buryalcin/EE464_Hardware_POWERLOVERS/README.md

# EE464_Hardware_POWERLOVERS
EE464 Hardware Project Repo by Burak Yalçın &amp; Emre Deniz Şenel
