buryalcin/EE464_Hardware_POWERLOVERS/Latex/Appendix.tex

\section{Appendix : Bill of Material Files}

\includepdf[pages=-]{BOM.pdf}
\includepdf[pages=-]{BOM_1000.pdf}
