buryalcin/EE464_Hardware_POWERLOVERS/Latex/References.tex

\begin{thebibliography}{9}
\bibitem{1} 
Transformer Design with Magnetics Ferrite Cores. [Online]. Available: https://www.mag-inc.com/Design/Design-Guides/Transformer-Design-with-Magnetics-Ferrite-Cores.

\bibitem{2}
"AN-776 20 Watt Simple Switcher Forward Converter", 2020. [Online]. Available: https://www.ti.com/lit/an/snva027a/snva027a.pdf?ts=1592752724490

\bibitem{3}
 N. Mohan, T. M. Undeland, and W. P. Robbins, Power Electronics: Converters, Applications, and Design. Hoboken, NJ: John Wiley \& Sons, 2003.

\bibitem{4}
"Compensator Design Procedure for Buck Converter with Voltage-Mode Error-Amplifier", Infineon.com, 2020. [Online]. Available: https://www.infineon.com/dgdl/an-1162.pdf?fileId=5546d462533600a40153559a8e17111a.

\bibitem{5}
Designing Switching Voltage Regulators With the TL494", 2020. [Online]. Available: https://www.ti.com/lit/an/slva001e/slva001e.pdf?ts=1592314978873

\end{thebibliography}
