buryalcin/EE464_Hardware_POWERLOVERS/Latex/titlepage.tex

\begin{titlepage}
\newcommand{\HRule}{\rule{\linewidth}{0.5mm}}
\setlength{\topmargin}{0 in}
\begin{center}
\begin{figure}[!h]
\centering
\includegraphics [width=0.3\textwidth]{eelogo.png}
\end{figure}

\vspace{10mm}
\Huge{MIDDLE EAST TECHNICAL UNIVERSITY}\\
\vspace{5mm}
{\LARGE ELECTRICAL \& ELECTRONICS ENGINEERING}\\

\HRule\\[0.4cm]
\textsc{\Large{EE464 - STATIC POWER CONVERSION II}}\\
\textsc{\Large{Hardware Project - Forward Converter \#1\\}}
\textsc{\Large{PowerLovers\\}}
\textsc{\Large{Final Report\\}}
\HRule\\[0.4cm]

\vspace{3mm}

\end{center}
\begin{minipage}{1\textwidth}
		\begin{flushleft}
			\large
			
			Emre Deniz  \textsc{Şenel - 2167237}\\
			Burak \textsc{Yalçın      - 2167534}\\

		\end{flushleft}
	\end{minipage}

\vspace{10mm}
\begin{center}
\large{24.06.2020}
\end{center}
\end{titlepage}
