buryalcin/EE464_Hardware_POWERLOVERS/Hardware_Final_Report.pdf

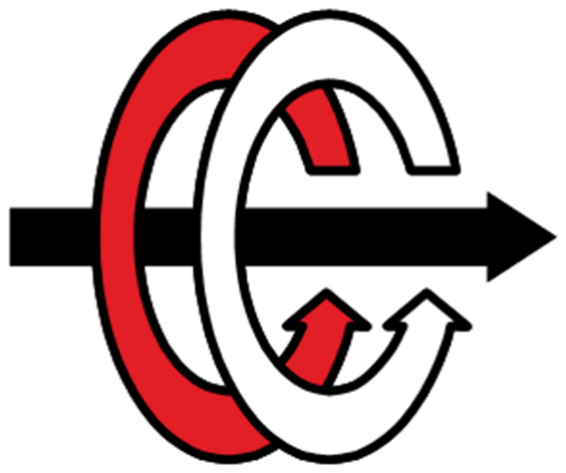
[picture p3: figure]

# MIDDLE EAST TECHNICAL UNIVERSITY

## ELECTRICAL & ELECTRONICS ENGINEERING

EE464 - STATIC POWER CONVERSION II

Hardware Project - Forward Converter #1

PowerLovers

Final Report

Emre Deniz Şenel - 2167237

Burak Yalçın - 2167534

24.06.2020

## Contents

1 Introduction | 3
2 Problem Definition, Objectives and Bonus Points | 3
3 Forward Converter | 4
4 Design of the Forward Converter | 5
5 Ideal Simulations | 12
6 Non-idealities of Forward Converter | 15
7 Transfer Function and Compensator Design | 19
8 Efficiency and Thermal Analysis | 30
9 PCB Design | 34

1

10 Conclusion | 45
11 Appendix : Bill of Material Files | 46

2

## 1 Introduction

Static Power Conversion II, a self-defined course, offers numerous isolated and non-isolated converters, inverters and their applications. In Spring’20, the theoretical background that have been acquired is to be turned into a hardware implementation of the combined knowledge all together. However, due to the pandemic, it is not possible to introduce a product but present a detailed design with software supports and PCB design. In this report, forward converter design of group Powerlovers will be introduced. Background information with objectives will take place. Then, all the steps of the projects, tests, design procedures and simulation results will be exhibited. We strongly believe, this project helped us understand the concepts we learnt in the lectures, and we had a chance to see beyond the horizons.

## 2 Problem Definition, Objectives and Bonus Points

In the project, we are to do a forward converter design with specific properties.

Table 1: Parameters of the project

Minimum Input Voltage (V) | 24
Maximum Input Voltage (V) | 48
Output Voltage (V) | 15
Output Power (W) | 48
Output Volt. Peak-to-Peak Ripple (%) | 2
Line Regulation (%) | 2
Load Regulation (%) | 2

Some of the points and objectives can be itemized as:

- Closed loop is a must and we are not allowed to use digital controllers
- PCB design of the converter will be presented.
- Bill of material will be presented
- Closed loop compansator design with bode-plot is a bonus
- We are to do thermal design and efficiency analysis of the project

We have mentioned couple of specifications of the project. Our goal was to accomplish the main specifications and add as much as bonus we can.

In the next section we are introduce a forward converter.

3

## 3 Forward Converter

### 3.1 General Structure

Forward converter is basically derived from the buck converter. We are going to observe the relationship in the derivation phase. Forward converter is isolated as we know, and it uses transformer as its regular use. Transformer transfers the power to the secondary side and it does not store energy in between. In forward converter, it is important to take the magnetizing current into account.

In Figure 3.1.1, the forward converter topology can be observed. This is the most simple model.

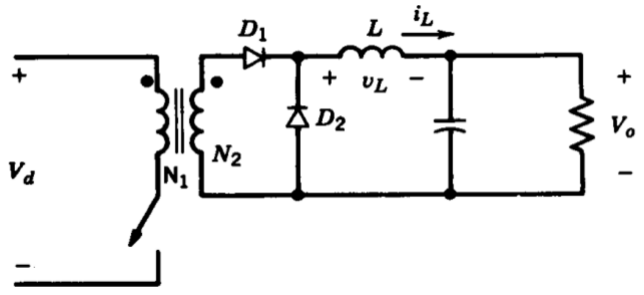
[picture p4: figure]

Figure 3.1.1: Forward Converter Topology

Assume the transformer is ideal for now to obtain the transfer function of the topology.
During the ON state of the switch, D1 is conducting and D2 is reverse biased. Therefore, the inductor voltage can be written down as

VL =

N2
N1

Vd − Vo

Let us examine now the OFF state of the switch. D1 is now reverse biased on D2 forms a free-wheeling path for the inductor. Load is fed by the stored energy in the inductor and the capacitor. Inductor voltage is easy to obtain and is as follows.

VL = −Vo

Discussion so far end with applying the voltage-seconds rule for the inductor and this yields the transfer function of the forward converter topology as

Vo
Vd

=

N2
N1
D | (1)

4

However, a question might arise rightfully at this point: how does this topology deal with the magnetizing current? During the OFF state, Lm has no path to discharge and it seems to be charged again and again during ON state. This situation ends up saturating the core and threatens the proper operation of the converter.
A variety of solutions for this problem are available. A snubber circuitry connected in parallel to the primary winding, a two switch topology are among them. A more practical and wide-spread application ,however, is adding a third reset winding. The resultant topology can be seen in Figure 3.1.2.

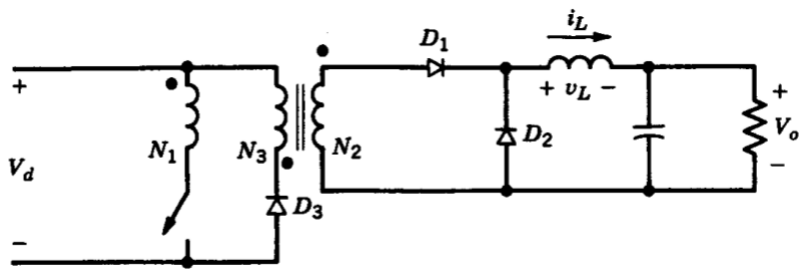
[picture p5: figure]

Figure 3.1.2: Practical Forward Converter Topology

In this topology, the third winding namely N3 is in use in order to reset the winding so that the core does not saturate. As its nature opposes, the forward converter has limitations itself. One and the most important thing is that Dmax namely maximum duty cycle is limited to the following equation

Dmax =

1
1 + N3/N1

(2)

In most of the cases, N1 = N3 is taken to simplify the structure and the organization. We followed the same approach in our solutions.

## 4 Design of the Forward Converter

### 4.1 System Level Design

The most important element in isolated power supplies is the transformer. Without knowing the transformer properties, it is not possible to move on with the simulations. Hence, the design process is now orderly. Output inductor and capacitor can also be chosen by theoretical knowledge.

5

Although it is possible to have a "pre-simulation" idea on the voltage stresses or current carrying capabilities for the semiconductor devices in the topology, it is safer to choose them in the guidance of the simulation results. Some of the non-idealities will also be involved in the simulations as well, allowing us to make more accurate assumptions about component selection.

In this part, we need to look at general specifications of the forward converter. Our customer, from Habelsan, asked us to satisfy these specifications:

- Input voltage rate: 24V − 48V
- Output voltage: 15V
- Output power: 48W
- Output voltage ripple: 2%, maximum
- Line and Load regulations: 2%, maximum

Firstly, we need to look at input-output voltage relationship of the forward converter. Ratio between the two is derived in the previous parts as:

Vo
Vd

=

N2
N1
D | (3)

Output current’s average value is 48W
15V = 3.2A. As mentioned before, demagnetization of the core in the forward converter is important. Among different techniques,it is decided to use a reset winding. Turn number of the reset winding is chosen to be equal to that of the primary winding, conventionally and we will stick to that convention as well. This situation puts a restriction on the duty cycle to ensure proper demagnetization of the core.Duty cycle for the operation should be D < 0.5.

Turns Ratio & Duty Cycle

In the project, required voltage transfer ratios are 48V to 15V, and 24V to 15V. It is important to take into account that the limit of duty cycle is Dmax = 0.5, and it is very crucial to reset all the core.

Using the input output equation and duty cycle restrictions, we choose the turn ratio between first and secondary winding as:

N2
N1

= 2

Using these ratio, it is now easy to find required duty ratios. For 48V input,

D =

48
15

= 2 =⇒ Dmin = 0.156

6

and For 24V input,

D =

24
15

= 2 =⇒ Dmax = 0.3125

As can be seen, the duty cycle ratios obey the restrictions and they also allow a margin to compensate for the non-idealities.

Frequency

As switching frequency of the MOSFET, it is important to note that higher frequencies increases the switching losses. Also, at high frequencies, skin depth of the cable decreases dramatically. Moreover, it is also needed to be pointed that at higher frequencies hysteresis losses increase in the core. Therefore, we decided to keep our frequency less than 30kHz, f < 30kHz

Secondly, as frequency decreases, the amount of ripple at the output increases due to longer switching periods. Furthermore, it is important to keep the frequency at inaudible range so that the converter is not noisy. We decided that frequency should be higher than 20kHz, f > 20kHz.

Combining these two
20kHz < f < 30kHz

In the simulations, we decided as the best frequency would be 25kHz. Therefore, for our forward converter the frequency is f = 25kHz

### 4.2 Transformer Design

In the forward converter topology, it is important to realize the fact that transformer is introduced in order to transfer the power from primary to secondary. For this reason, we do not need any air gap in our transformer design. Moreover, a transformer with high inductance will allow us to operate in low magnetizing current levels due to high impedance of the inductor. When we combine these, we can start our calculations.

The first approach is to calculate W aAc, it shows the power handling capacity of our transformer. Its formula is as follows [1]:

WaAc =

PoDcma

KtBmaxf

(4)

Here Po = 48W, power out in watts, Dcma = 500 cir/mils.amp, is current density, Kt = 0.0005, topology constant given for forward converter. Bmax = 2500G, maximum flux density in gauss and f = 25kHz is the frequency.

When we calculate the result

WaAc = 0.768 cm⁴

7

Now, using the magnetics’ available cores offered for power handling capacities, we are going to choose a proper core. We chose an R material E shaped core, it is high in inductance and low in loss. It is very proper for this application.

The core link: Core (https://www.mag-inc.com/Media/Magnetics/Datasheets/0R43515EC.pdf)

Now it is important to choose turn number for primary side. The secondary and third windings depend on the primary side. We are going to apply following approach:

Np =

Vp10⁸
4BAcf

(5)

We choose following parameters for this application: Vp = 48V , B = 0.25T, Ac = 0.87cm² it given
in the datasheet of the core and f = 25kHz. The result is:

Np = 22 turn

Naturally, we have N1 = 22, N2 = 44, N3 = 22 due to our selection.

The turns number for windings are determined as

- Primary winding, n1 = 22 turns
- Reset winding, n3 = 22 turns
- Secondary winding, n2 = 44 turns

Now, it is very important to take magnetizing inductance into account. In the datasheet we can easily see that the AL value is given as AL = 2667nH/T²
. As we decided our turn number is 22, we can easily calculate the magnetizing inductance as:

Lm = 22²

∗ 2667 ∗ 10⁻⁹ = 1.3mH

This is a great value becuase a low magnetizing inductance will increase the magnetizing current at the primary side, as a result we would need a higher current capability. However, 1.3mH is a legitimate value. If we calculate the magnetizing current at operating frequency:

Im =

V
Z

= 0.235A

### 4.3 Cable Selection

In practical cases maximum fill factor achievable is stated at 50%. We need to take these two parameters into account.

8

Moreover, it is important to notice that, the input current at the maximum operation is Iin = 2A and Im = 0.235A, as overall we need minimum of I1 = 2.3A at the primary side. At the secondary side we are going to have a maximum of Io = 3.2A, we have to take these into account.

Using a simple approach 1mm² of cable can carry 4A, and considering skin depth. We have chosen to use AWG22 cable. It’s area is 0.327mm² and it can carry a current up to 1.3A. Also, it’s maximum skin depth is applicable up to 42kHz, that is to say since our operating frequency is 25kHz, this cable is proper to use. Considering margins, we are going to choose needed parallel cable amount.

In the output we need 2 parallel cables, and at the output we need 3 parallel cables.

Now, it is important to have a look at the fill factor. It is very crucial to have a fill factor around 50% so that our transformer is realizable.

If we calculate the cable areas:

Acable = 0.326 ∗ 22 + 0.326 ∗ 22 + 0.326 ∗ 44 = 71.9mm²

If we check our core’s window area, we can see that it is:

Awindow = 9.8 ∗ 8 ∗ 2 = 156.8mm²

So the fill factor of our transformer is:

k =

61.1
156.8

= 46%

This fill factor is applicable and not an overdesign. Therefore, the cable selections are proper. We have a legitimate fill factor, we have 100% skin depth, and we have margins so that there is no burnout. In the next step we are going to cover the capacitor and inductor.

### 4.4 Inductor and Capacitor Design

To design the inductor, we are focus on the maximum ripple current allowed. In the specifications, it is not determined, so we are going to have 20% maximum ripple current so that our output current would be out of harmonics and the filtering capacitor would be smaller.

At the ON period, the inductor is charging, and using the voltage among the terminals we can find the ripple current value.

∆I =

1
L

Z DTs

0

VLdt < 3.2A
5

∆I =

1
L

Z DTs

0

(Vs

N2
N1

− Vo)dt < 0.64A

9

0.62mH < L

Also, it is very important to take rated current into account. The minimum rated current that inductor can carry must be minimum of 3.2A + 0.65A ≈ 3.8A

Using digikey website, we chose a proper inductor. It is important to have a small inductor in order to decrease the size and the weight.

Inductor Link: Inductor (https://www.digikey.com/product-detail/en/bourns-inc/2300LL-681-H-RC/2300LL-681-H-RC-ND/725890)

Capacitor design is depending on the inductor design. As we know, we have to limit the ripple value of the output voltage. Also, the current that is flowing through the output is equal to the inductor current. We need to follow the following approach.

∆V =

∆Q
C

(6)

∆Q = ∆IL ∗

Ts
8

(7)

Here, we are using buck converter capacitor design approach. They are same in the application:

∆V = 0.3V >

DT²
s

(Vs

N2
N1

− Vo)

8LC

C > 28µF

Also, apparently the rated voltage of the capacitor should be higher than the rated voltage of the output, for that reason Cv,rated > 15V

Capacitor Link: Capacitor (https://product.tdk.com/info/en/documents/chara_sheet/C3216JB1E336M160AC.pdf)

ESR value of the capacitor is: 3 mΩ

### 4.5 Switch and Diode Design

In these voltage levels and frequency levels it is proper to use MOSFET due to their fast recovery. It is also easy to implement a MOSFET into a converter. While designing the MOSFET, it is very important not to exceed its rated voltage and current values.

In the simulations with idealities, we came up with the values that:

- Switch stress has its maximum values for input of 48V naturally. We can say that our switch must be endurable minimum of 100V rated reverse voltage and 10A forward voltage.

10

- Switch must be proper to operate at 25kHz range, reverse recovery times should be appropriate.

We have chosen an N-Channel MOSFET with ratings 10 A, 150 V. The MOSFET Link: MOSFET (https://www.digikey.com/product-detail/en/on-semiconductor/FDMS86255/FDMS86255TR-ND/4555505)

Silicon diodes are proper because they are cheap in cost and they have proper operation for this implementation range.

In the simulations with idealities, we came up with the values that:

- Diode’ stress have their maximum values for input of 48V naturally. We can say that switches must be endurable minimum of 100V rated reverse voltage and 4A forward voltage.
- Diode must be proper to operate at 25kHz range, reverse recovery times should be appropriate.

A Schottky diode with ratings 5A and 100 V is chosen for our application.

The Diode Link: Diode (https://www.digikey.com/product-detail/en/vishay-semiconductor-diodes-division/SS5P10-M3-86A/SS5P10-M3-86AGICT-ND/2048223)

11

## 5 Ideal Simulations

### 5.1 Simulation Results

Below in the Figure 5.1.1, the simulation model schematic can be seen.

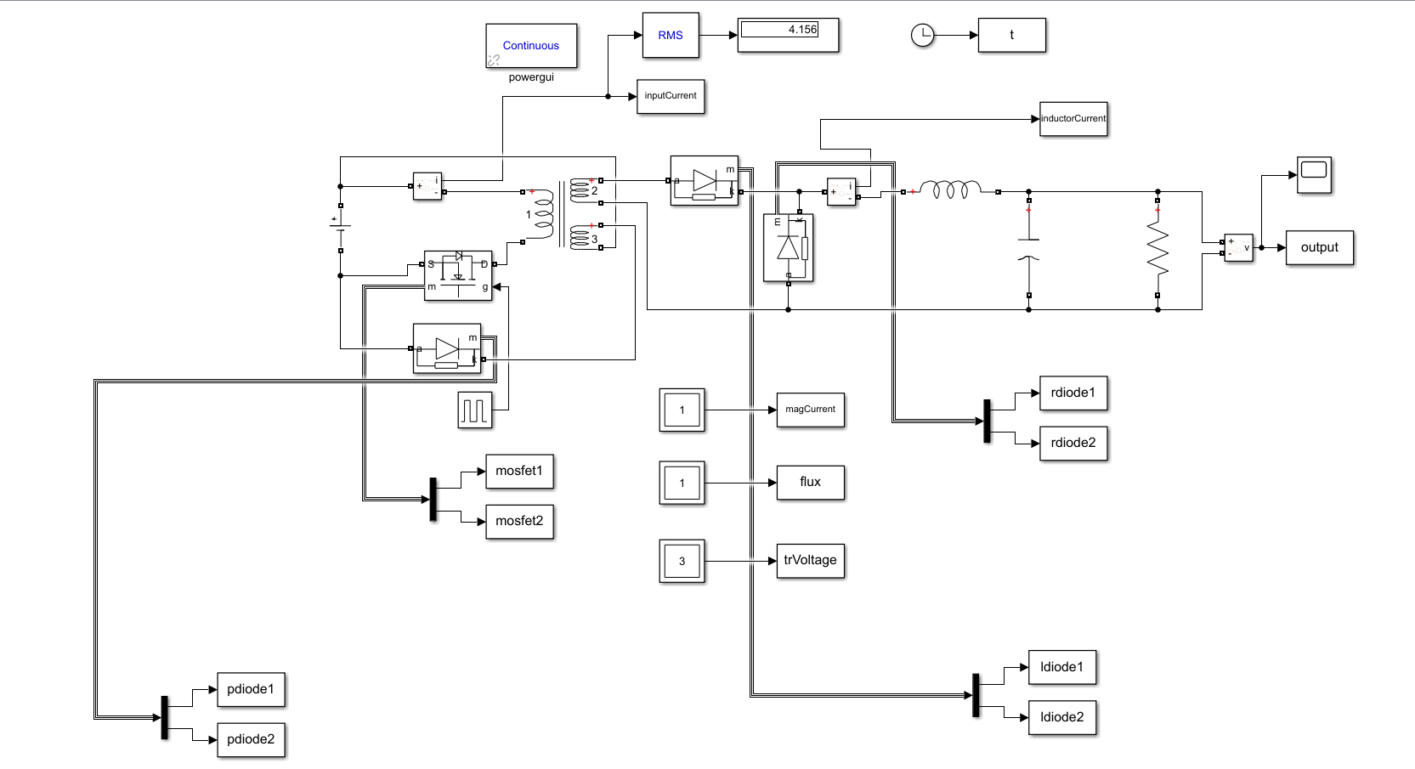
[picture p6: figure]

Figure 5.1.1: Simulation model

First, we simulated the ideal models in order to see the overall system operation. It is open-loop operation simulation and we would like to validate the duty cycles, operation principle and validity of our selections.

12

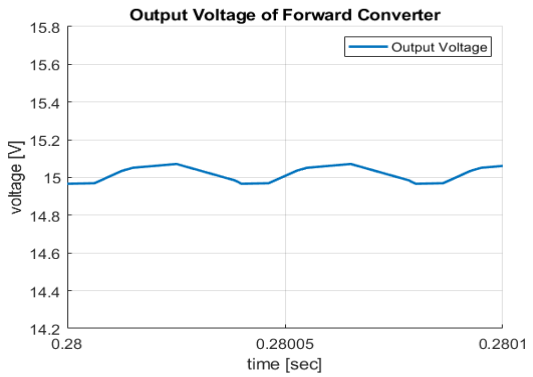
[picture p7: figure]

Figure 5.1.2: Output waveform of the forward converter under 48V operation

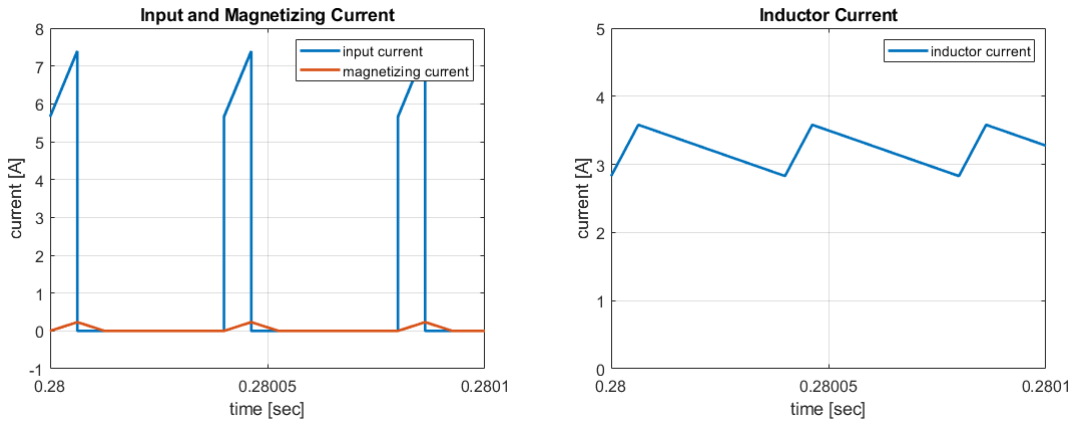
[picture p8: figure]

(a) Input and Magnetizing Current | (b) Inductor Current

Figure 5.1.3: Forward converter input and inductor current under 48V input operation

13

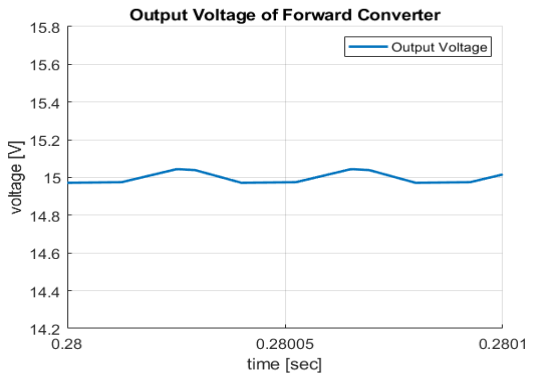
[picture p9: figure]

Figure 5.1.4: Output waveform of the forward converter under 24V operation

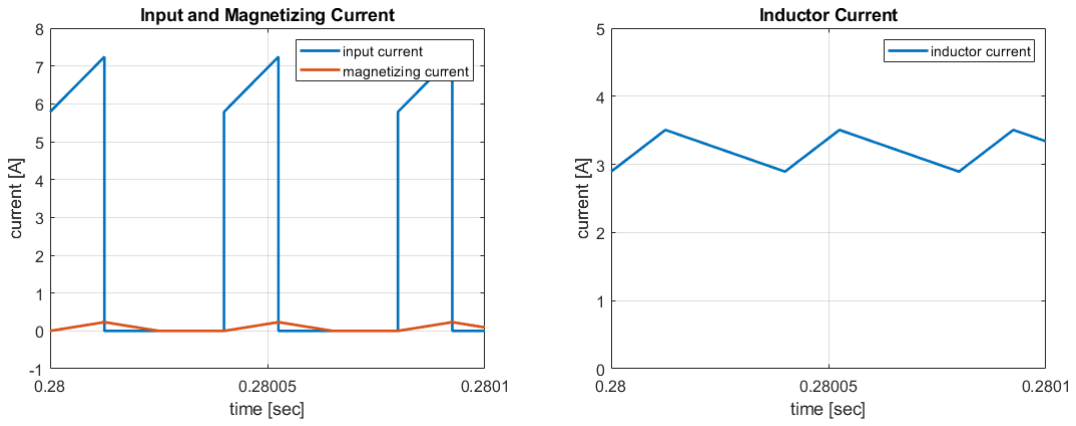
[picture p10: figure]

(a) Input and Magnetizing Current | (b) Inductor Current

Figure 5.1.5: Forward converter input and inductor current under 24V input operation

As we can see from the Fig. 5.1.4 and 5.1.2 the output ripple is below 2%. The operation is stable and the duty cycles are as expected. However, when non-idealities are presented the duty cycle values will be re-calculated in order to compansate the voltage drops of losses and diodes etc.

14

Also, from the Fig. 7.3.2 and 5.1.3, we can observe the magnetizing current is as expected around 0.3A and the inductor ripple is around 0.6A for both operations. These results show that our calculations are valid. Now we are going to add non-idealities of the circuit.

## 6 Non-idealities of Forward Converter

### 6.1 Adding the Non-idealities and Their Solutions

Firstly, we added the loss components of the MOSFET and the diodes. As we can see from the datasheet, MOSFET has Rds,ON = 12.4mΩ, this value is added to the MOSFET. Then, the forward voltage values of the diodes are added to the software Vf = 0.7V in our operation topology. After adding these, Rd,ON = 1mΩ added for the diodes representing the losses on the selected diodes.

Series resistance of the inductor is given as maximum of Rmax = 0.113Ω for convenience we took this value as 0.6Ω to obtain an average operation range. Also, using the datasheet of the capacitor, we found out that the ESR value of the capacitor is around 3mΩ. This is a low value, because the capacitor is a seramic capacitor and it has very low ESR operation.

Next step was to add the leakage inductances of the transformer, we have taken the leakage inductance as 1% of the magnetizing inductance and introduced the leakage inductance as 13µH to the primary side of the transformer. Also, copper resistances added to the non-ideal system. At primary R1 = 0.33Ω at secondary R2 = 0.44Ω

Then it is very crucial to notice that the stored energy in the leakage inductance needs a way to decharge itself. For this very reason it is very important to design a snubber circuit around the MOSFET in order to block burnouts and have a smooth operation. We have decided to move on with a RC Snubber.

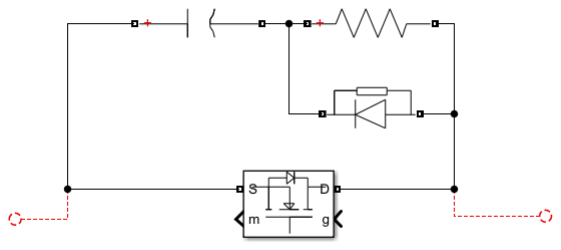
[picture p11: figure]

Figure 6.1.1: Snubber Layout

When designing the RC snubber we can use an
Application Note [2], in the application note, there is a snubber designed. We changed the R and C variables in order to adjust the solution into our problem. We have twice of voltage at the input and the current is twice. So, we used four times of R and two times of C. The values and the layout is in Figure 7.3.1:

R = 1250Ω, C = 0.5µF

### 6.2 Simulation of Non-ideal Case

When we introduce all the non-idealities and run the simulation, the result is surprising. The output voltage waveform can be seen in Figure 6.2.1

15

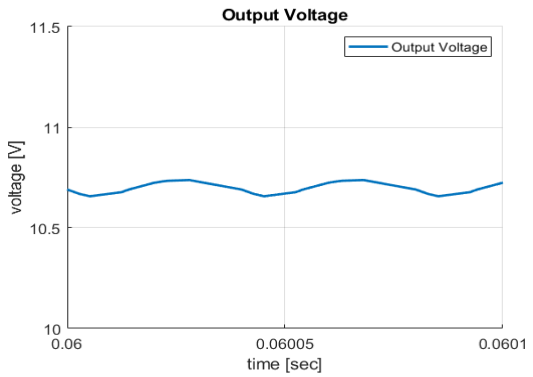
[picture p12: figure]

Figure 6.2.1: Output waveform of the forward converter 24V operation non-ideal

We can see that due to the drops on the diodes, and the series parasitic resistances, the output voltage almost dropped to the 10.7V . In order to compansate this value, we need to boost the duty cycle. We boost duty cycle to the 43.5% for 24V operation.

16

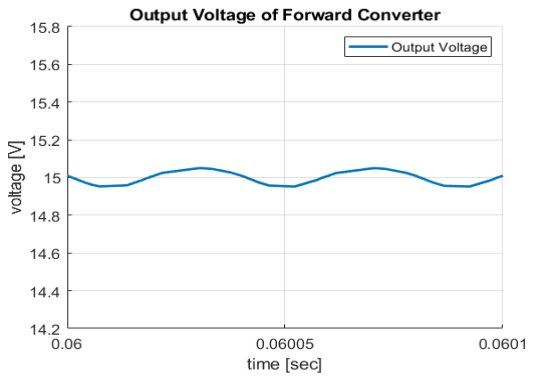
[picture p13: figure]

Figure 6.2.2: Output waveform of the forward converter 24V operation non-ideal

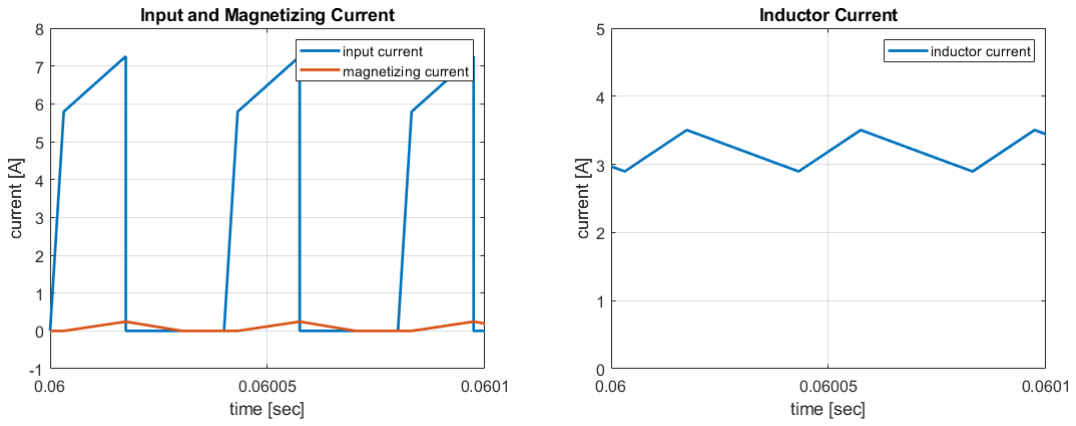
[picture p14: figure]

(a) Input and Magnetizing Current | (b) Inductor Current

Figure 6.2.3: Forward converter input and inductor current under 24 non-ideal operation

17

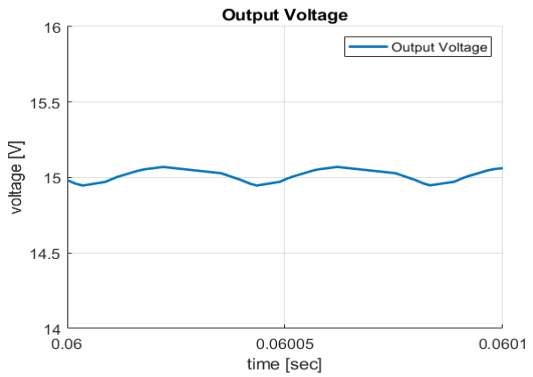
[picture p15: figure]

Figure 6.2.4: Output waveform of the forward converter 48V non-ideal operation

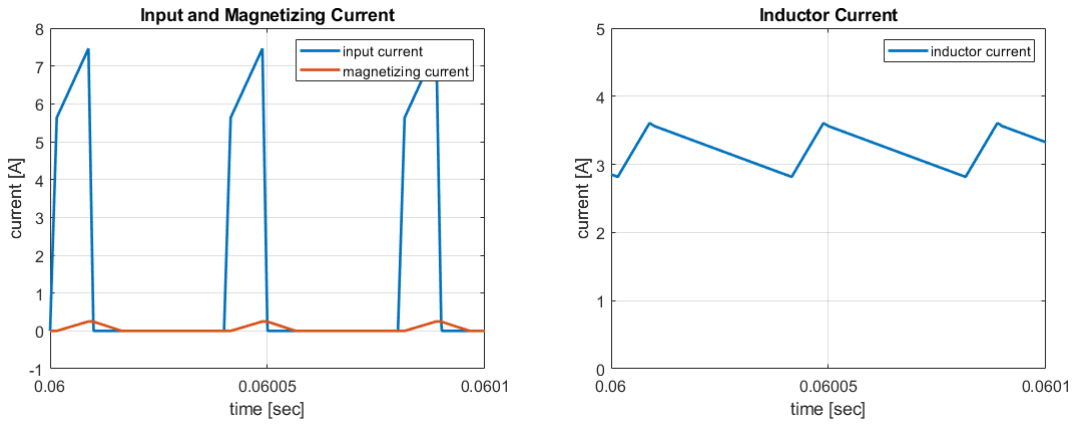
[picture p16: figure]

(a) Input and Magnetizing Current | (b) Inductor Current

Figure 6.2.5: Forward converter input and inductor current under 48V non-ideal operation

The above simulations are for the non-ideal case with open-loop operation. Non-idealities drop the output voltage almost 2/3 of its value and decreases efficiency. Efficiency analysis will be done in the following parts.

18

In the ideal operations the duty cycles were calculated as: Dmin = 15.65% and Dmax = 31.25%. However, in the non-ideal cases these values arised to higher values. So, it is very important to take non-idealities into account. This may result in inapplicable duty cycle values. Fortunately, our turn ratio decision N = 2 is enough for non-ideal operation. Our non-ideal case duty cycles are:

Dmin = 22.05%, and Dmax = 43.5%

One of the most important parts is the snubber around the switch. We know that the leakage inductance of the transformer create high voltages around the switch and causes burn outs. We designed a snubber circuit and introduced it. The results of non-ideal switching with snubber is below:

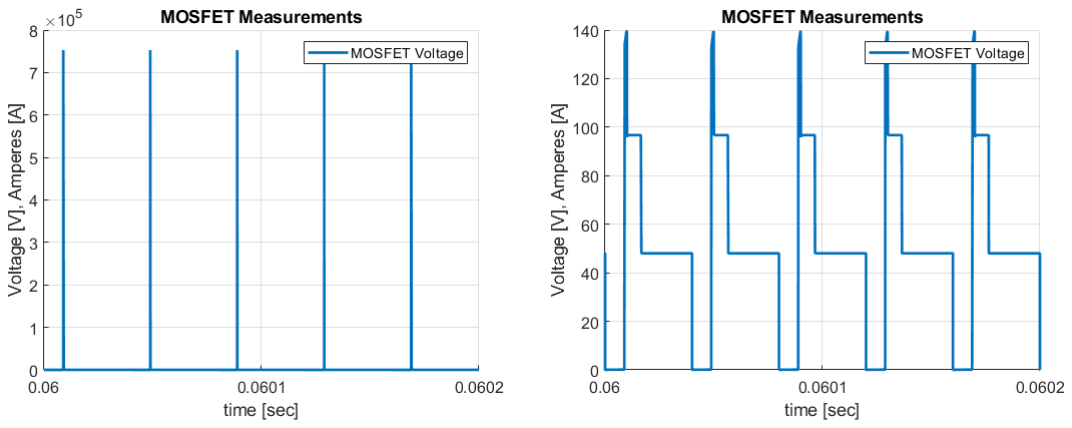
[picture p17: figure]

(a) MOSFET Voltage without Snubber | (b) MOSFET Voltage with Snubber

Figure 6.2.6: Snubber effect on the MOSFET operation with leakage inductance

Since our MOSFET has a rated voltage of 150V, it is applicable. This snubber design is working.

## 7 Transfer Function and Compensator Design

### 7.1 Transfer Function Derivation

In the transfer function derivation, we are going to use averaging method. [3]

In the forward converter below Figure 7.1.1 we can observe the forward converter. Here, we are starting with defining the x1 = iL and x2 = vc. These two states will be taken into account from now on.

19

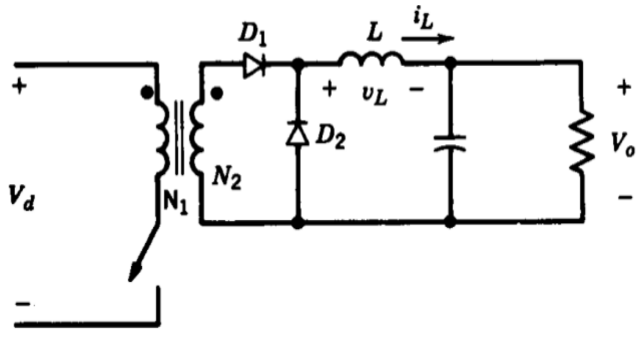
[picture p18: figure]

Figure 7.1.1: Forward Converter Topology

When we use the averaging method. It is important to use the switch ON and switch OFF models of the converter. Below, we can observe these models in Fig. 7.1.2.

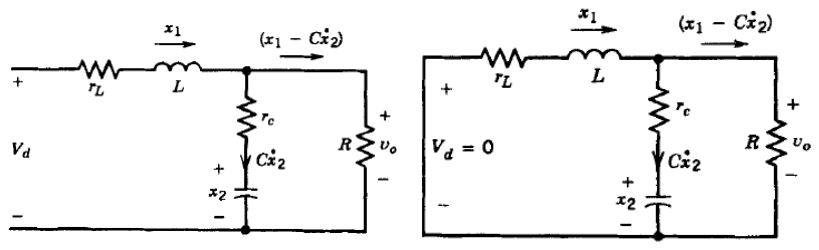
[picture p19: figure]

(a) Switch ON | (b) Switch OFF

Figure 7.1.2: Forward converter averaging models switch on (a) and switch off (b)

In the first model, we can write that: assuming turn ratio is N.

− NVd + rLiL + L ˙iL + R(iL − CvĊ ) = 0 | (8)

and

− vc + CrcvĊ + R(iL − Cvċ) = 0 | (9)

20

Basically, when switch is on if we call this state space representation number 1, then it will have following structure:

˙iL
vĊ
=

−

Rrc + RrL + rC rL
L(R + rC )

−

R
L(R + rC )
R
C(R + rC )

−

1
C(R + rC )

iL
vC
+

"

1
L
0
NVd | (10)

Let us call this state space representation as

x˙ = A1x + B1u

When the switch is off, we can write following equations:

rLiL + L ˙iL + R(iL − CvĊ ) = 0 | (11)

and

− vc + CrcvĊ + R(iL − Cvċ) = 0 | (12)

Switch is off, if we call this state space representation number 2, then it will have following structure:

˙iL
vĊ
=

−

Rrc + RrL + rC rL
L(R + rC )

−

R
L(R + rC )
R
C(R + rC )

−

1
C(R + rC )

iL
vC
(13)

Let us call this state space representation as

x˙ = A2x

As we can easily see A1 = A2 and more importantly B2 = 0. Therefore averaging is much easier in this topology. Now, we can say that

A = A1D + A2(1 − D) = A1 | (14)

and

B = B1D | (15)

Let’s derive the output. If we are to define the output as vo then we can write that

vo = R(iL − CvĊ ) | (16)

21 in state space form for both switch on and off cases

vo =

Rrc
R + rC

iL

R
R + rc

vC

(17)

To simplify these state space representations, we will follow a simple approach. In our circuitry, rc = 3mΩ, rL = 60mΩ where R = 4.7Ω. Starting from this point, apparently, we can assume that

R (rC + rL) | (18)

so A is simplified as:

A =

−

rc + rL
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
- (19)

B is simplified as:

B =

"

1
L
0
D | (20)

C is simplified as:

C =

rC 1
(21)

Now, we need to introduce small signal perturbations to the system.

d = D + ˜d | (22)
vo = Vo + ṽo | (23)

and
x = X + ˜x | (24)

Now the equation becomes:

x˜˙ = Ax˜ + BNVd

˜d | (25)

and

võ = Cx˜ | (26)

when we use the laplace transformation:

22

x˜(s) = [sI − A]

−1
(B1Vd)
˜ d(s) | (27)

So, output to control transfer function can be written as:

võ(s)
˜d(s)

= C[sI − A]

−1BNVd | (28)

võ(s)
˜d(s)

= NVd

1 + srC C

LC(s

2 + s(

1
RC +

(rc + rL)
L

) + 1
LC )

(29)

### 7.2 Bode Plot of the Forward Converter

Let’s have a look at to the bode plot of the forward converter. In the ideal case where capacitor and inductor resistance does not exist, the transfer function can be simplified as:

võ(s)
˜d(s)

= NVd

1

LC(s

2 + s

1
RC +

1
LC )

(30)

When we obtain its bode plot using Matlab, the resulting graph is below Fig 7.2.1a. Also, below we have non-ideal bode plots Figure 7.2.1b and 7.2.2b

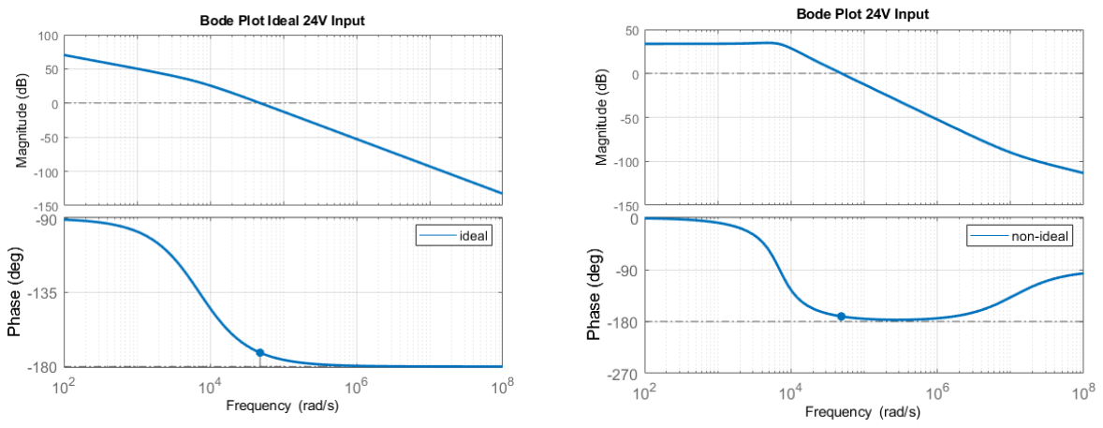
[picture p20: figure]

(a) Ideal | (b) Non-ideal

Figure 7.2.1: Bode plot with input 24V ideal (a) and non-ideal (b)

23

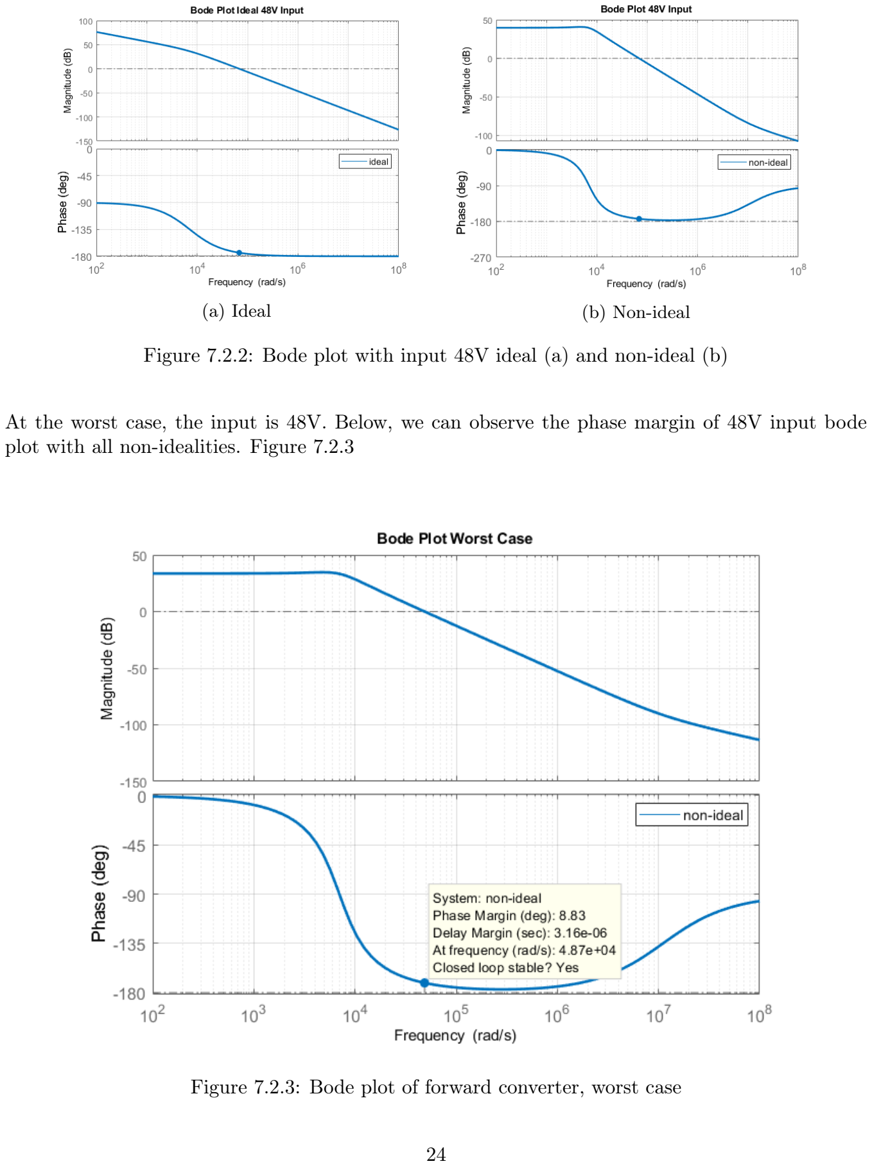
[picture p21: page 25]

(a) Ideal | (b) Non-ideal

Figure 7.2.2: Bode plot with input 48V ideal (a) and non-ideal (b)

At the worst case, the input is 48V. Below, we can observe the phase margin of 48V input bode plot with all non-idealities. Figure 7.2.3

Figure 7.2.3: Bode plot of forward converter, worst case

24

As we can follow, forward converter is a stable converter with a very small phase margin. Nevertheless, we need to design a compensator that will boost the phase of the converter so that we can operate in stable region with considerable speed. Now, we are going to design a compensator to make this system more stable. Also, we want to operate in constant output voltage!

### 7.3 Compensator Design

Basically, a forward converter and a boost converter have similar transfer functions. Its difference is that the input voltage reflects with a turn ratio, nonetheless, the rest is almost same. Therefore, we can apply a buck compensator for the forward converter, and make it work! We are applying the procedure in the given note. [4]

Firstly, it is important to see that we need to boost our phase margin due to increase stability. An operation around 40-70°will be enough for our operation. It is obvious that we need a type three compensator to boost our phase margin. Also, if we calculate the frequencies of the circuitry we can easily see that:

Fesr =

1
2πRESRCo
= 1.77MHz | (31)

FLC =

1
2π

√
LC
= 1.11kHz | (32)

F0 =

fs
10
= 2.5kHz | (33)

Basically, we can see that:

FLC < FO < FS/2 < FESR | (34)

We should use Type-III Compensator! Also, it is very convenient because we have used a ceramic capacitor at the output!

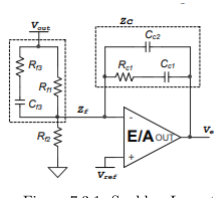
[picture p22: figure]

Figure 7.3.1: Snubber Layout

At this point, we need to introduce the
schematic of compensator! This compensator consists of 3 poles and 2 zeros. One pole is an integrator, which makes the steady state error zero. So, at the low frequencies we have a −90° boost shift. However, at the proper locations we have a phase boost up to 90° theoretically. Here, an important factor is that, at the oscillator we are using 1.8V oscillator voltage with the frequency of 25kHz. It is significant that, we should have a duty cycle limit of Dmax = 0.5.

25

Nonetheless, we can apply further duty cycles, the third winding will be a problem. So, Vref must be maximum of 0.9V for operation.

Vref = 0.9V | (35)

Here is the transfer function:

H(s) = | (1 + sRC1 + CC1)(1 + sCf3(Rf1 + Rf3))

sRf1(CC1 + CC2)(1 + sRC1(

CC1CC2
CC1 + CC2

)(1 + sRf3Cf3

(36)

FZ1 =

1
2πRC1CC1

(37)

FZ2 =

1
2πCf3(Rf1 + Rf3)

(38)

Fp1 = 0 | (39)

Fp2 =

1
2πRf3Cf3

(40)

Fp3 =

1
2πRC2CC2

(41)

Now, it is important to decide the pole and zero locations in order to have a proper compensator. We place the Fp3 to the Fs/2 to have a low-pass structure, and to eliminate the ripples above the switching frequency.

Fp3 =

Fs
2

= 12.5kHz

Now, we need to design the lead-compensator part. As we know, a type-3 compensator can boost up the phase margin maximum of 90 °. However, in practical it is maximum 80 °. A phase-lead compensator consists of one pole and one zero. This compensator must be located at the crossover frequency to boost up the phase margin. We should use following formulas:

FZ2 = F0

r
1 − sin θ
1 + sin θ

Fp2 = F0

r
1 + sin θ
1 − sin θ

Since, my phase margin is negative right now, i should get the maximum of phase shift. We put the θ at limit, θ = 80°. Since, i selected the crossover frequency as Fs/10 the zero of the lead-compensator will result in increment of the gain. We were expecting an increase in gain in the lead-compensator part.

26

FZ2 = 418Hz

Fp2 = 28.38kHz

We chose the second zero before the first one in order not to have decrements in the gain. It is significant to sustain gain level. We chose

FZ1 =

FZ2
2

= 210Hz

After this point, we need to select a proper capacitor for Cf3, i choose this capacitor value as 2.2nF.

Rf3 ≈ 2.55kΩ

then

Rf1 ≈ 170kΩ

using this the data given in the application note:

RC1 =

2πF0LoCoVosc

VinCf3

There, since it is a forward converter the capacitor and inductor values are what they are!

RC1 ≈ 5.46kΩ

using RC1

CC1 = 140nF

CC2 = 2.33nF

Rf2 =

Rf1Vref

Vout − Vref

= 10.9kΩ

27

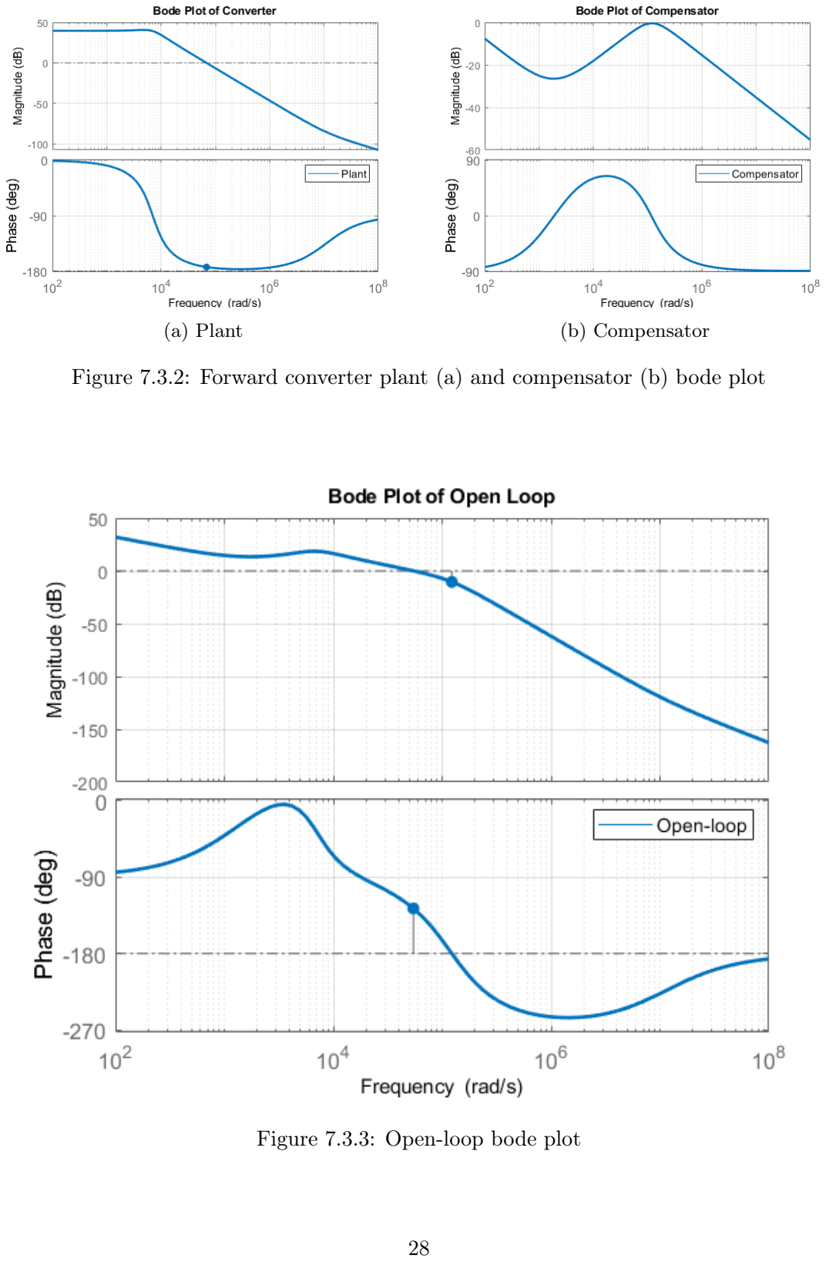
[picture p23: page 29]

(a) Plant | (b) Compensator

Figure 7.3.2: Forward converter plant (a) and compensator (b) bode plot

Figure 7.3.3: Open-loop bode plot

28

In the resultant bode plot, we can see that the phase margin is boosted up to 55°and the bandwidth is very convenient. Let’s construct the LTSpice model of this compensator.

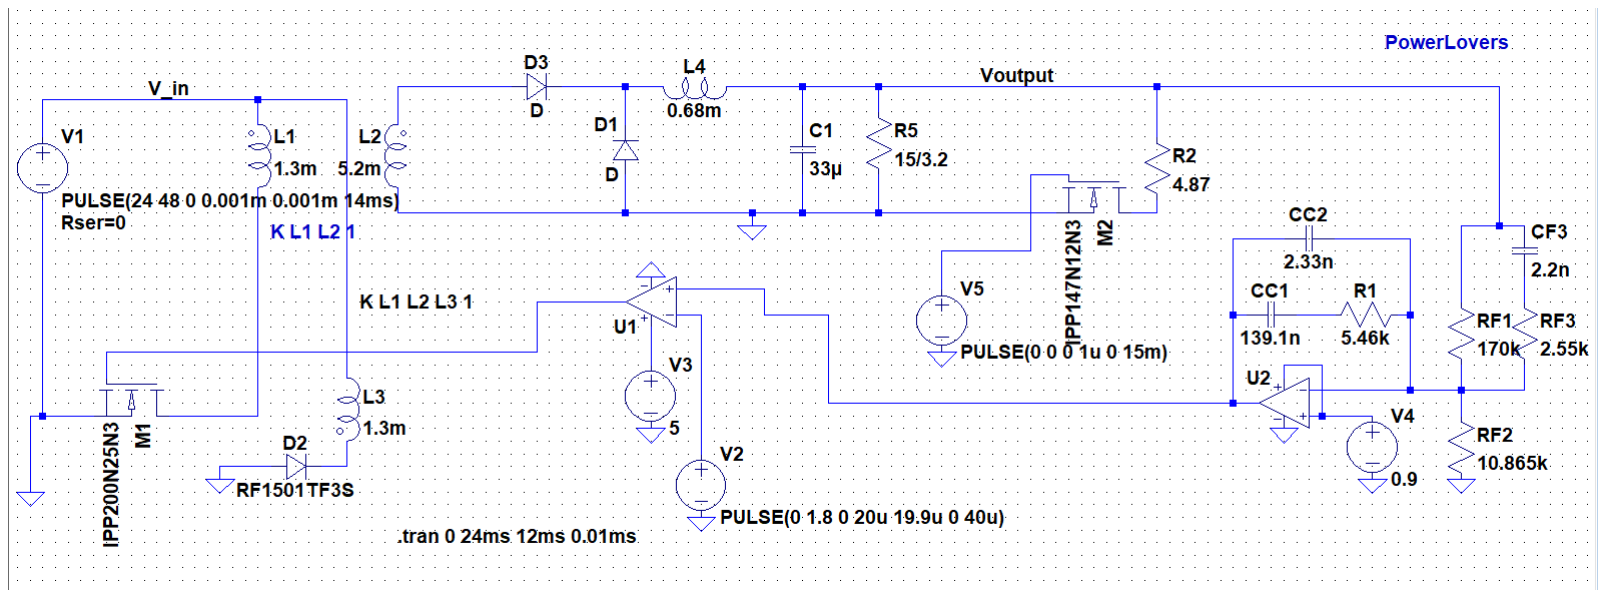
[picture p24: figure]

Figure 7.3.4: Forward converter with compensator

To simulate the line regulation and load regulation, first we increased the input from 24V to 48V, and observed the output. Below in the Fig 7.3.5 we can see the output waveform. We changed the output from 24V to 48V at 2ms.

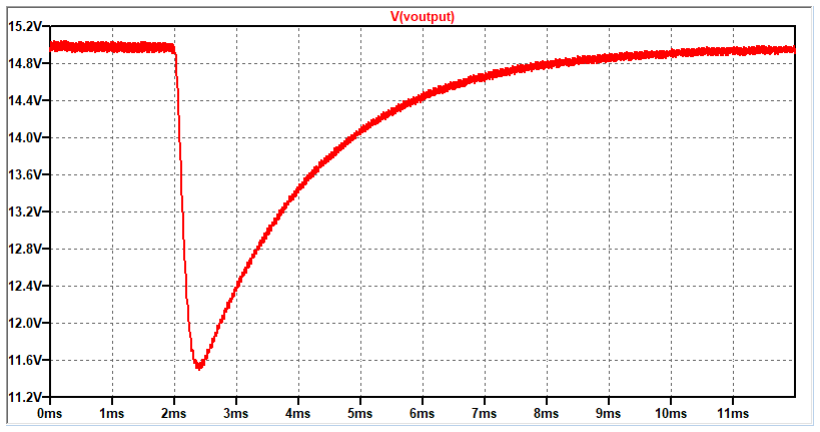
[picture p25: figure]

Figure 7.3.5: Input change line regulation

29

Fig 7.3.5 shows that the line regulation is below 2%, the output goes back to 15V after the line regulation, and it continues its operation. The transient is stable and we observe an overshoot around the regulation time. Therefore, our compensator design is valid. Let’s now look at the load regulation.

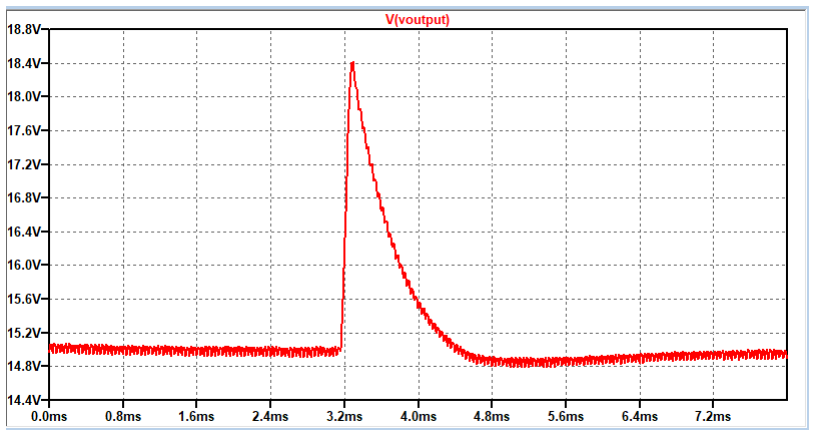
[picture p26: figure]

Figure 7.3.6: Load change, load regulation

Again, in the Fig 7.3.6, we can observe that the load regulation is less than 2%. In this case at 3ms, we increased the load from 0.32A, to 3.2A (full load) and we can see that after the transient our load regulation is as expected. We have some overshoot during the transient.

In this part, we designed our compensator and now we have a closed loop operation. The converter is stable and line, load regulations are below 2 %.

## 8 Efficiency and Thermal Analysis

### 8.1 Efficiency Analysis

In the project, the converter is non-ideal, and there are losses expected to be. Now, analytically, one by one, we are going to cover the losses on the circuit.

Capacitor ESR Losses

30

Over the capacitor, the current that will flow is the amount of inductor current ripple. So, the average current over the capacitor is

Ic =

∆ILTs
8
= 0.31A | (42)

Easily, the loss on the ESR of the capacitor is:

Pesr,loss = 0.31²
∗ 0.003 = 0.3mW | (43)

It is a quite low value because we have chosen a ceramic capacitor.

Inductor ESR Losses

Over the inductor, the current flowing is 3.2A since output current is equal to inductor average current.

PL,loss = 3.2

2
∗ 0.06 = 0.61W | (44)

Diode Losses

Over the diodes, inductor current is flowing. So, easily:

PD,loss = 0.7 ∗ 3.2 = 2.24W | (45)

MOSFET Loss

Over the MOSFET, the loss at 10A current is given in the datasheet as 2.4W. We are going to use this value:

PMOSF ET = 2.4W | (46)

Transformer Loss

At the primary side:

Ppri = 0.033 ∗ 2

2 = 0.13W | (47)

At the secondary side:

Psec = 3.2

2
∗ 0.045 = 0.46 | (48)

At the third winding

31

Pthird = 0.22²
∗ 0.33 = 0.016W | (49)

For the core loss, we should calculate the loss:

Using the Magnetics R Material loss calculator, we have 124mW/cm³ | loss in the core. Our core
has a volume of 5.6 ∗ 2 = 11.2cm³
Pcore = 0.124 ∗ 11.2 = 1.4W | (50)

Total Loss

Total loss over the circuit is ignoring the leakage inductance:

Ptotal = 0.003W + 0.61W + 2.24W + 2.4W + 0.13W + 0.46W + 0.016W + 1.4W = 7.3W (51)

Efficiency

Efficiency, ignoring the loss around the snubber:

η =

Pout

Pout + Ploss

=

48W
48W + 7.3W

=

48W
55.3W
= 86.7% | (52)

When, we simulate the circuit without using the snubber circuit the resultant efficiency is:

ηsim =

Pout

Pin

=

48W
52.12W
= 92% | (53)

However, this value does not include the core loss. When we analytically add the core loss on it!

ηtotal =

48W
54.62W
= 87.8% | (54)

Analytical calculations and simulation results are so similar!!

When we think of the snubber circuit, we can see that the average current around the snubber is:

Isnubber =

0.1
2
= 0.05A | (55)

Psnubber = 0.05²
∗ 1250 = 3.1W | (56)

So, efficiency including the snubber is:

32

ηsn,total =

48W
59W
= 81% | (57)

In the simulations, the efficiency simulated is 79%. We can say that we have an efficiency of 80% including the snubber circuit, leakage inductance, all ESR values and MOSFET, diode losses. This is a good efficiency for a forward converter.

### 8.2 Thermal Analysis

Losses on semiconductors are calculated in the previous subsection. By looking at their values and the thermal resistances of these components, we can have an idea if the temperature of these devices are within the operating range. Heatsinks can be used to cool them down. A heatsink suggestion will be made for the components in this section.

MOSFET

Loss on MOSFET is calculated as 2.4 W. Thermal resistance is obtained from the datasheet. Two values are given based on the mounting specification of the device. If a copper pad is built under it the thermal resistance decreases significantly but that was not the practice in our design.

Normally, thermal resistance of the MOSFET is given as 113°C. Considering that the device can work properly up to 150 , a heatsink is definitely required. Junction to case thermal resistance of the MOSFET is
Rjc = 1.1 °C/W

A heatsink as small as possible is chosen from DigiKey website. Datasheet can be found here. (https://www.digikey.com/product-detail/en/aavid-thermal-division-of-boyd-corporation/577102B00000G/HS106-ND/108319) It is cheap yet efficient. Thermal resistance value for the heatsink is

Rsink = 25.9 °C/W

Assuming that the ambient temperature is 25 C°, operating temperature for the MOSFET junction can be found as follows.

Top = Tamb + Ploss ∗ (Rjc + Rsink) =⇒ Top = 25 + 2.4 ∗ 27 ≈ 90°C

This value is reasonable for our device and operation can continue safely with no problems.

Diodes

From the datasheet, loss is obtained as 2.24 W on diodes. This value is very close to that of MOSFETs. Thermal resistance of diode is obtained from the datasheet as

Rjc = 3 °C/W

Same heatsink can be used for the diodes as well. Similar calculation yields nearly the same result.

Top = Tamb + Ploss ∗ (Rjc + Rsink) =⇒ Top = 25 + 2.24 ∗ 28.9 ≈ 90°C

33

We can say that with the suggested heatsink, semiconductors can operate at temperatures around
90. Switching losses are not included in the calculations since switching frequency is relatively low, but the margin is high enough to compensate for them as well.

## 9 PCB Design

A PCB design is done for the converter, as requested by the recent changes in the hardware project. An open source PCB design tool, KiCad is used for the design. Lots of schematic symbols and footprints created by the users were available online. The transformer model is created by the team only.

### 9.1 Feedback Controller

To keep the voltage constant at 15V and to satisfy the line/load regulations, instead of the previously designed compensator, an analog IC controller is implemented on PCB. A very popular PWM controller IC for power supplies, TL494 by Texas Instruments is chosen. Additional features comes with it makes it a favorable choice and in this section, some of them that are implemented in our design are to be presented.

Pin configuration of the module can be seen at Fig 9.1.1

34

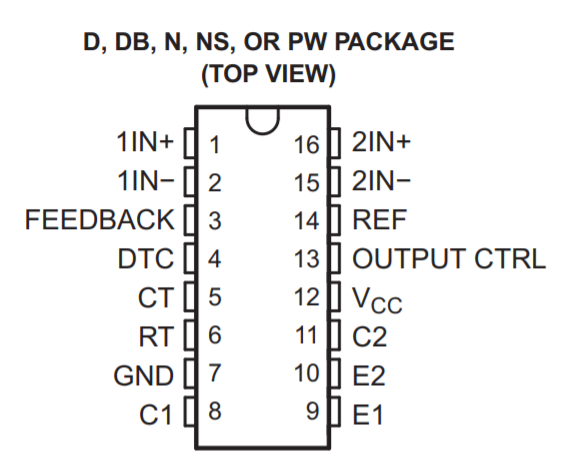
[picture p27: figure]

Figure 9.1.1: Pin Configuration for TL494

Powering Up TL494

To power up the module properly, a DC-DC converter is used. Input voltage to TL494 is set to 12 V. A DC-DC converter module by Artesyn Inc., ATA00B36S-L is used. It can supply 3W of power at 12 V from an input between 18-75 V. Our input voltage to the system falls in its operation range, therefore this module can be used with no problems. Datasheet regarding this module can be found here. (https://www.artesyn.com/assets/ata_series_ds_01apr2015_79c25814fd.pdf)

Basic Wiring For the wirings described as of this subsection, the application note by the TI is used. [5] TL494 is able to drive two switches together, but only one of the outputs is to be used in our project. First of all, the switching frequency of the module should be set. It is done by a simple RC circuit connected to pins 5 and 6. Internally it connects to the oscillator of the module and sets the frequency. Switch frequency is 25 kHz in our design.

fswitch =

1
RT CT

35

Standard values are chosen for the components and fswitch ≈ 25.9kHz is achieved.

RT = 8.2 kΩ

CT = 4.7 nF

One of the error amplifiers in the module is for regulating the output voltage. The working principle is simple. Inverting input is fed by a constant voltage value from the voltage reference of the module. 2.5 V is chosen for this. And the non-inverting input is fed from the output voltage of the converter. A schematic is given in Fig 9.1.2.

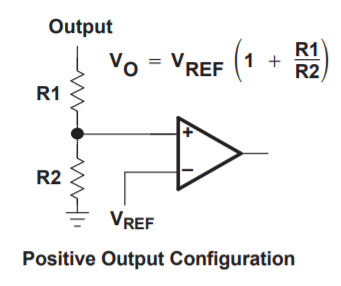
[picture p28: figure]

Figure 9.1.2: Output Voltage Regulation by TL494

Output voltage of the converter is 15V, therefore the voltage divider resistances are chosen as follows.
R1 = 10 kΩ

R2 = 2 kΩ

Amplifier gain is increased to 101 with a simple feedback loop formed between pins 2 and 3, inverting input and output of the amplifier respectively. Two resistors with ratings 51kΩ and 510kΩ are used to achieve this.

Current Limitation

36

A second error amplifier is reserved for output current limitation. When the output current goes beyond the adjusted value, the gate signal to the converter is cut therefore a short-circuit protection is implemented by the control circuitry.

Again, voltage reference output of the controller is fed to the inverting input of the current error amplifier. Voltage is set to 1V here. The current limit here is chosen as 5A in our application. Therefore, a really small resistor, referred to as R13 in Fig 9.1.3, is connected in series with the load. In our application it is chosen as 0.2Ω.

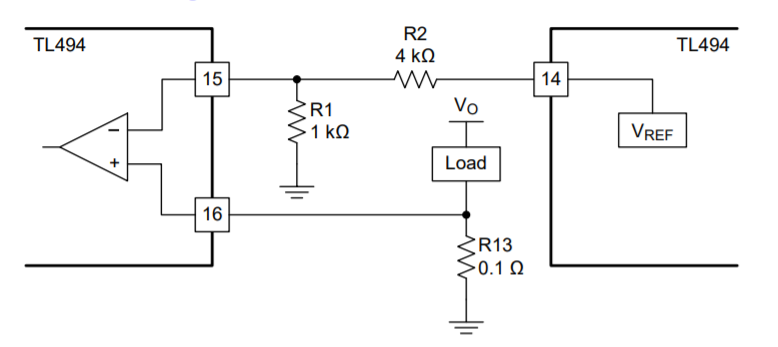
[picture p29: figure]

Figure 9.1.3: Short Circuit Protection by TL494

Soft Start Application

There is only on switching element in our design, therefore the dead time application is not needed. Nevertheless, a soft starting mechanism is added. The wiring can be seen at Fig 9.1.4.

37

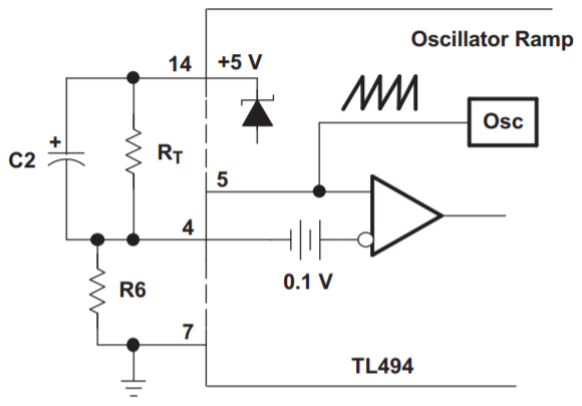
[picture p30: figure]

Figure 9.1.4: Soft Start with TL494

At the beginning of the regulation, C2 capacitor charges through R6 and by this way, the output pulse slowly increases till the control loop takes command. Considering R6 is about one tenth of RT resistor, which corresponds to a 1kΩ resistance, the capacitor value can be calculated as follows. 50 cycles is chosen for the soft start time.

C2 =

Sof t − start duration
R6

=

40µs ∗ 50
1kΩ

≈ 2.2µF

Gate Driver

To ensure electrical isolation between input and output sections of the converter, an optocoupler is to be used to drive the switching element. Our choice for this element is TLP250 by Toshiba. It is a familiar IC for us, since it is used previously on the hardware project of EE463. A seperate power supply is needed to drive the gate driver, therefore there are two power input pin pairs to the converter : one for the main supply and for the gate driver.

### 9.2 Schematic

A schematic is the first step to create a PCB. Kicad’s "Eeschema" tool is used for this means. Generic symbols for diodes, inductors and such are used. Semiconductor symbols were available at the library. The symbol created for the three-winding transformer can be seen at Fig 9.2.1.

38

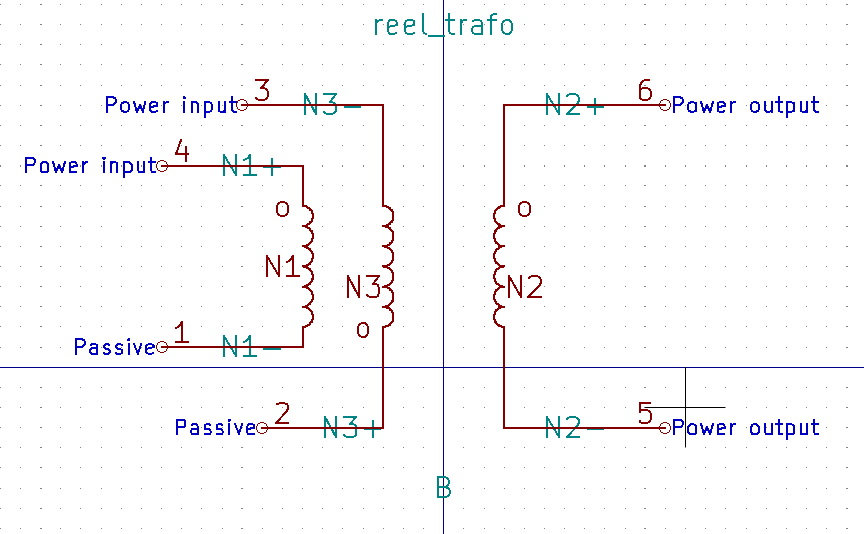
[picture p31: figure]

Figure 9.2.1: Schematic Symbol for Transformer in KiCad

Necessary wirings for TL494 are done as told in previous subsection. DC-DC Converter is added. Resulting schematic can be seen at Fig 9.2.2.

39

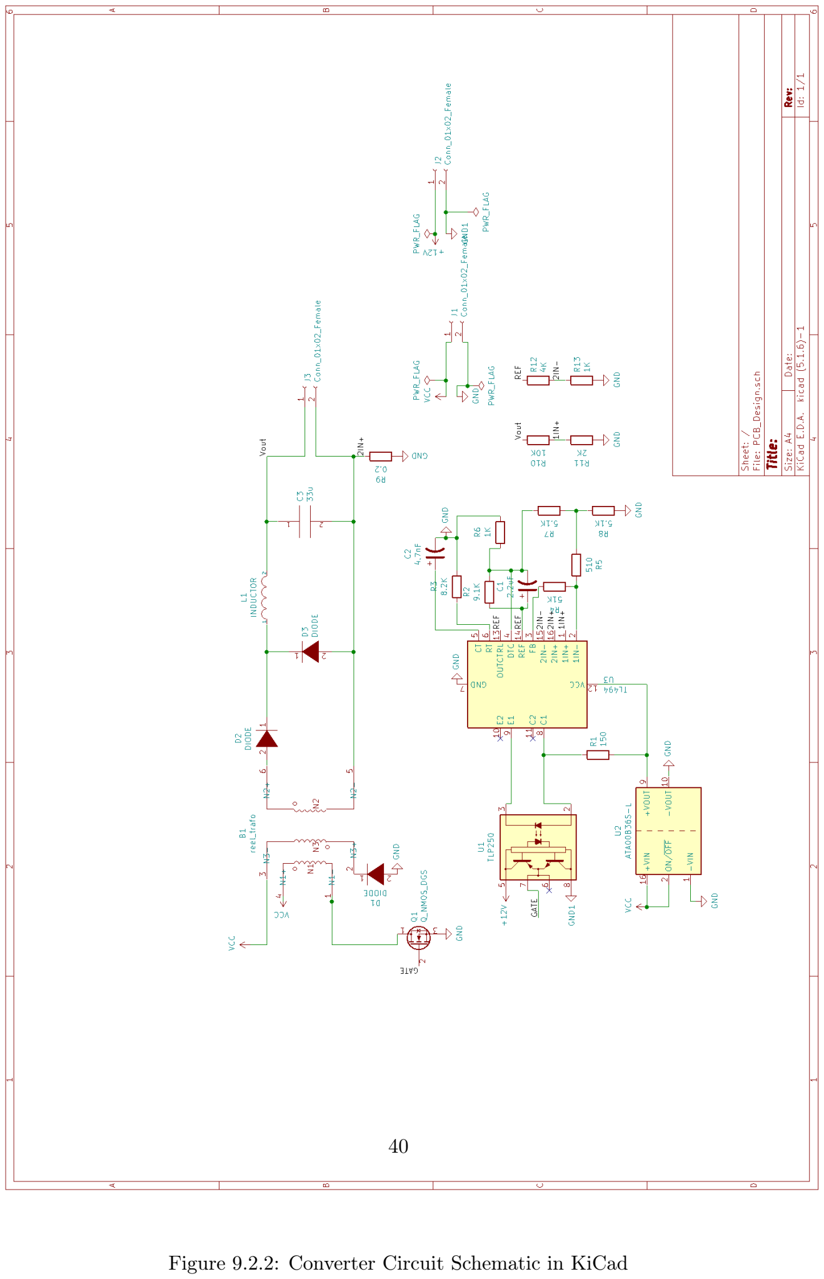
[picture p32: page 41]

Figure 9.2.2: Converter Circuit Schematic in KiCad

40

### 9.3 Footprints

After the schematic is completed, components should be annotated and footprints should be as-signed to each one of them. The packages are matched with each component chosen. The list for the components used in the PCB Design and the corresponding footprint selections can be seen in Fig 9.3.1.

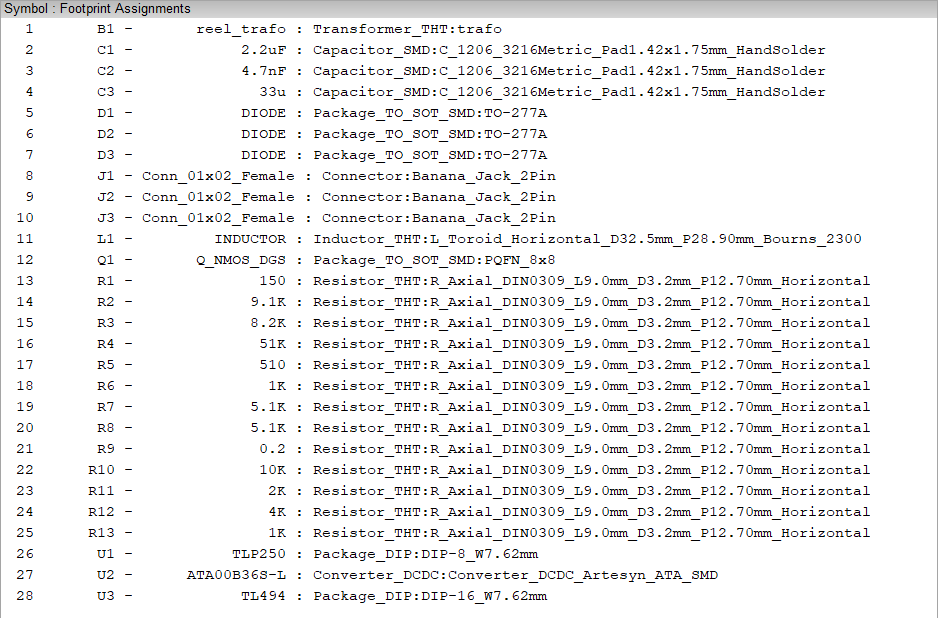
[picture p33: figure]

Figure 9.3.1: Footprint List in KiCad

A footprint for the transformer was not readily built, since the transformer is to be designed by the team. Only the transformer’s footprint is custom made. The dimensions of the chosen core is taken into consideration. 6 pads are formed for each ends of three windings. The resulting footprint can be seen in Fig 9.3.2.

41

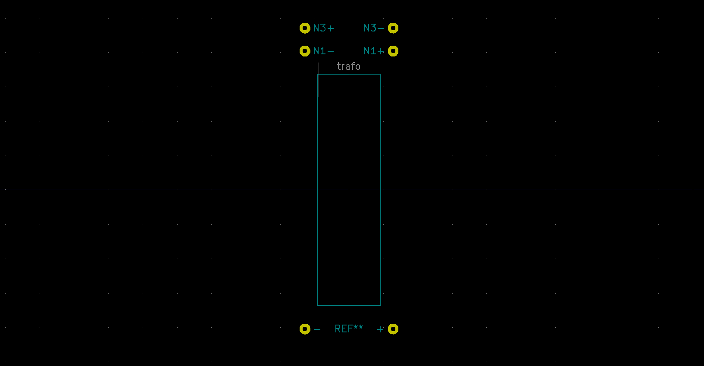
[picture p34: figure]

Figure 9.3.2: Footprint for Transformer

### 9.4 PCB View

After all these arrangements are made, the PCB design process can begin. There are some basic rules to that, although we are not so experienced in PCB design we tried to apply all we know.

First of all, traces should not make perpendicular turns. This can cause serious EMI problems and should be avoided all the times. Second thing that is considered with utmost attention is the trace widths. In the converter, currents can reach up to 3-4 A during operation. A simple PCB trace width calculator is used to make sure that our design can carry such currents. For control parts, default trace width is used but at the input and output stages, trace widths are 22 and 32 mils, respectively. It is assumed that 2oz/f t² of copper will be used.

In order to make connections easier and to use less vias, through hole resistors are used. This can be changed and compactness could be improved but overall, the design looked neat enough to us. Some components are flipped when necessity occured. 3-4 vias are used as well.

The PCB View of the design can be seen in Fig 9.4.1 at the next page. The copper filling for the back layer is also done but to make components and connections more visible, it is not given in the following representation.

42

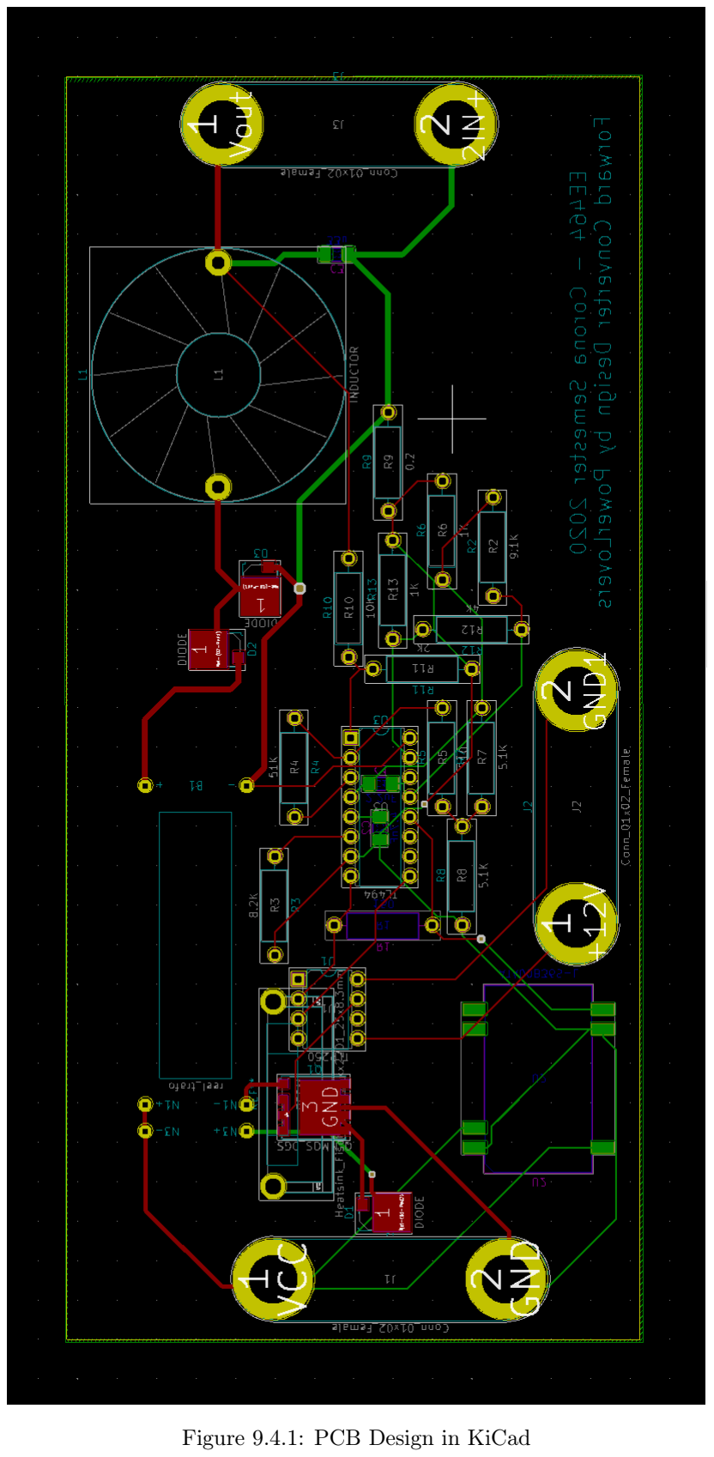
[picture p35: page 44]

Figure 9.4.1: PCB Design in KiCad

43

9.5 3-D View

Transformer and connector models are absent but a 3-D View of the project is presented below.

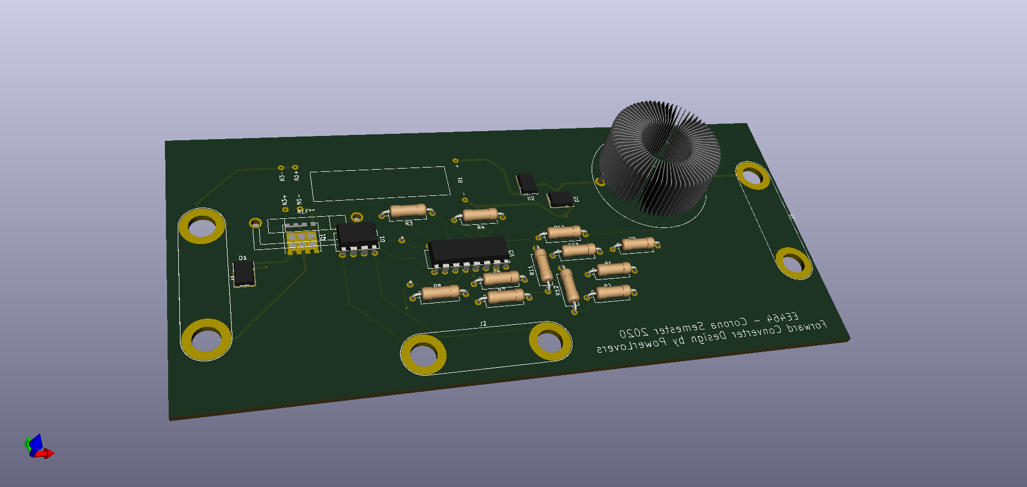
[picture p36: figure]

Figure 9.5.1: 3-D View of the PCB, Top Layer

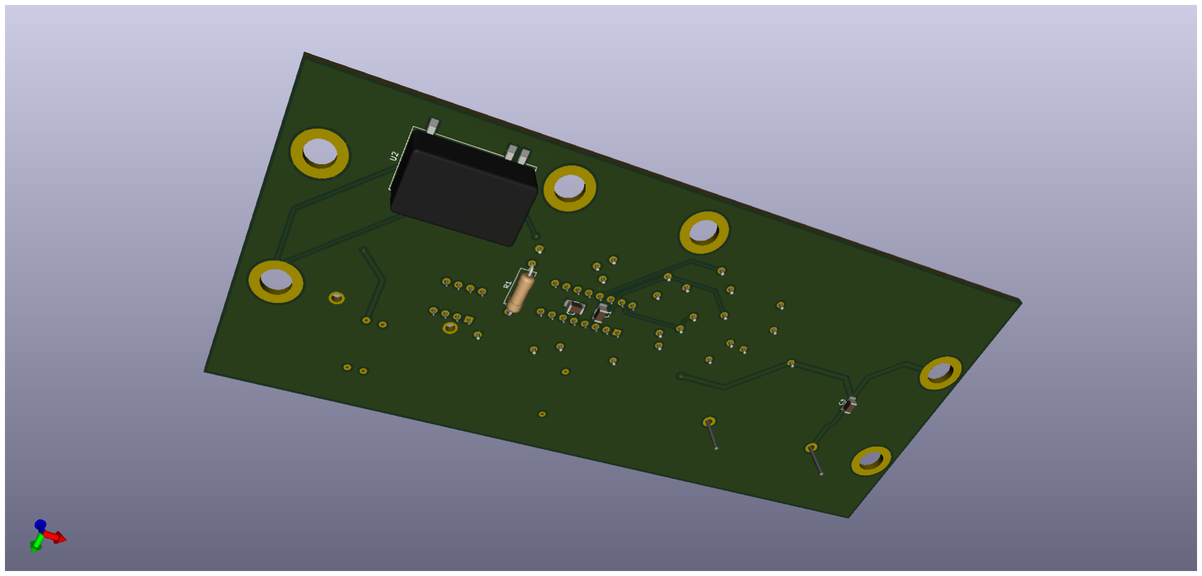
[picture p37: figure]

Figure 9.5.2: 3-D View of the PCB, Bottom Layer

44

### 9.6 Arrangement for 1000 Pieces from PCBWay

When the design is completed, Gerber files are obtained and the board is ready for production. As suggested in the GitHub page, PCBWay has been the choice for producing the board. Price for 5 pieces, which is the minimum number allowed is calculated as $ 63 and for 1000 pieces it is $ 1320.

Component prices are given in detail in the Bill of Materials (BOM) presented in the following pages. Overall manifacturing costs are calculated from BOMs.

- One piece production cost : $52.43
- 1000 piece production, cost per piece : $28.95

It can be easily seen that mass production is more profitable. For each cases BOMs are presented in the Appendix. Original Excel files can be found at GitHub repository.

## 10 Conclusion

In this report, we have introduced PowerLovers forward converter closed loop design, PCB implementation, and analysis in means of efficiency, thermal durability, and affordability. We included non-ideal simulations with supported analysis and calculations. We strongly believe that this project allowed us to understand more about all the theoretical knowledge we have gained so far. Also, by doing research, we have met advanced information about converters, snubber design, cores, efficiency, switches, stability... It was a great opportunity to work on such a project all together. Apart from the project, it is also essence of power electronics to understand how to design from beginning to the end considering all the relations between the electronics and nature itself. We hold on that we are now more experienced designing converters!

45

## 11 Appendix : Bill of Material Files

46

Reference | Quantity | Value | Footprint | Price
B1 | 1 trafo | Transformer_THT:trafo | $ | 4.00
C1 | 1 2.2uF | Capacitor_SMD:C_1206_3216Metric_Pad1.42x1.75mm_HandSolder | $ | 0.29
C2 | 1 4.7nF | Capacitor_SMD:C_1206_3216Metric_Pad1.42x1.75mm_HandSolder | $ | 0.10
C3 | 1 33u | Capacitor_SMD:C_1206_3216Metric_Pad1.42x1.75mm_HandSolder | $ | 1.20
D1 D2 D3 | 3 DIODE | Package_TO_SOT_SMD:TO-277A | $ | 0.62
J1 J2 J3 | 3 Conn_01x02_Female Connector:Banana_Jack_2Pin | $ | 1.44
L1 | 1 INDUCTOR | Inductor_THT:L_Toroid_Horizontal_D32.5mm_P28.90mm_Bourns_2300 | $ | 2.83
Q1 | 1 Q_NMOS_DGS | Package_TO_SOT_SMD:PQFN_8x8 | $ | 1.82
R1 | 1 150 | Resistor_THT:R_Axial_DIN0309_L9.0mm_D3.2mm_P12.70mm_Horizontal | $ | 0.10
R10 | 1 10K | Resistor_THT:R_Axial_DIN0309_L9.0mm_D3.2mm_P12.70mm_Horizontal | $ | 0.10
R11 | 1 2K | Resistor_THT:R_Axial_DIN0309_L9.0mm_D3.2mm_P12.70mm_Horizontal | $ | 0.10
R12 | 1 4K | Resistor_THT:R_Axial_DIN0309_L9.0mm_D3.2mm_P12.70mm_Horizontal | $ | 0.63
R2 | 1 9.1K | Resistor_THT:R_Axial_DIN0309_L9.0mm_D3.2mm_P12.70mm_Horizontal | $ | 0.63
R3 | 1 8.2K | Resistor_THT:R_Axial_DIN0309_L9.0mm_D3.2mm_P12.70mm_Horizontal | $ | 0.10
R4 | 1 51K | Resistor_THT:R_Axial_DIN0309_L9.0mm_D3.2mm_P12.70mm_Horizontal | $ | 0.10
R5 | 1 510 | Resistor_THT:R_Axial_DIN0309_L9.0mm_D3.2mm_P12.70mm_Horizontal | $ | 0.10
R6 R13 | 2 1K | Resistor_THT:R_Axial_DIN0309_L9.0mm_D3.2mm_P12.70mm_Horizontal | $ | 0.10
R7 R8 | 2 5.1K | Resistor_THT:R_Axial_DIN0309_L9.0mm_D3.2mm_P12.70mm_Horizontal | $ | 0.10
R9 | 1 0.2 | Resistor_THT:R_Axial_DIN0309_L9.0mm_D3.2mm_P12.70mm_Horizontal | $ | 3.08
U1 | 1 TLP250 | Package_DIP:DIP-8_W7.62mm | $ | 1.15
U2 | 1 ATA00B36S-L | Converter_DCDC:Converter_DCDC_Artesyn_ATA_SMD | $ | 16.39
U3 | 1 TL494 | Package_DIP:DIP-16_W7.62mm | $ | 0.53

Total Price :
https://www.pcbway.com/QuickOrderOnline.aspx | PCB Price
Overall
Core Eq | https://www.digikey.com/product-detail/en/tdk-electronics-inc/B66381G0000X172/495-76794-ND/3914869
Around 2 dollars
Cable | AWG #22 - Around 2 dollars

Total Price | Datasheet
$ | 4.00 https://www.mag-inc.com/Media/Magnetics/Datasheets/0F43515EC.pdf
$ | 0.29 https://www.digikey.com/product-detail/en/murata-electronics/GRM155R60J225ME15D/490-4519-1-ND/1033278
$ | 0.10 https://www.digikey.com/product-detail/en/murata-electronics/GRM155R71H473KE14D/490-10702-1-ND/5251398
$ | 1.20 https://product.tdk.com/info/en/documents/chara_sheet/C3216JB1E336M160AC.pdf
$ | 1.86 https://www.digikey.com/product-detail/en/vishay-semiconductor-diodes-division/SS5P10-M3-86A/SS5P10-M3-86AGICT-ND/2048223
$ | 4.32 https://www.digikey.com/product-detail/en/cinch-connectivity-solutions-johnson/108-0901-001/J150-ND/5928
$ | 2.83 https://www.digikey.com/product-detail/en/bourns-inc/2300LL-681-H-RC/2300LL-681-H-RC-ND/725890
$ | 1.82 https://www.digikey.com/product-detail/en/on-semiconductor/FDMS86255/FDMS86255TR-ND/4555505
$ | 0.10 https://www.digikey.com/product-detail/en/stackpole-electronics-inc/CF14JT150R/CF14JT150RCT-ND/1830603
$ | 0.10 https://www.digikey.com/product-detail/en/stackpole-electronics-inc/CF14JT10K0/CF14JT10K0CT-ND/1830374
$ | 0.10 https://www.digikey.com/product-detail/en/stackpole-electronics-inc/CF14JT2K00/CF14JT2K00CT-ND/1830357
$ | 0.63 https://www.digikey.com/product-detail/en/vishay-dale/CMF554K0000FEBF/CMF554K0000FEBF-ND/3634189
$ | 0.63 https://www.digikey.com/product-detail/en/yageo/MFP-25BRD52-9K1/9-1KADCT-ND/2059152
$ | 0.10 https://www.digikey.com/product-detail/en/stackpole-electronics-inc/CF14JT8K20/CF14JT8K20CT-ND/1830372
$ | 0.10 https://www.digikey.com/product-detail/en/stackpole-electronics-inc/CF14JT51K0/CF14JT51K0CT-ND/1830392
$ | 0.10 https://www.digikey.com/product-detail/en/stackpole-electronics-inc/CF14JT510R/CF14JT510RCT-ND/1830343
$ | 0.20 https://www.digikey.com/product-detail/en/stackpole-electronics-inc/CF14JT1K00/CF14JT1K00CT-ND/1830350
$ | 0.20 https://www.digikey.com/product-detail/en/stackpole-electronics-inc/CF14JT5K10/CF14JT5K10CT-ND/1830367
$ | 3.08 https://www.digikey.com/product-detail/en/ohmite/15FR200E/15FR200E-ND/822920
$ | 1.15 http://toshiba.semicon-storage.com/info/docget.jsp?did=16821&prodName=TLP250
$ | 16.39 https://www.artesyn.com/power/assets/ata_series_ds_01apr2015_79c25814fd.pdf
$ | 0.53 http://www.ti.com/lit/ds/symlink/tl494.pdf
$ | 39.83
$ | 12.60
$ | 52.43

Reference | Quantity | Value | Footprint | Price
B1 | 1 trafo | Transformer_THT:trafo | $ | 2.00
C1 | 1 2.2uF | Capacitor_SMD:C_1206_3216Metric_Pad1.42x1.75mm_HandSolder | $ | 0.06
C2 | 1 4.7nF | Capacitor_SMD:C_1206_3216Metric_Pad1.42x1.75mm_HandSolder | $ | 0.01
C3 | 1 33u | Capacitor_SMD:C_1206_3216Metric_Pad1.42x1.75mm_HandSolder | $ | 0.38
D1 D2 D3 | 3 DIODE | Package_TO_SOT_SMD:TO-277A | $ | 0.24
J1 J2 J3 | 3 Conn_01x02_Female Connector:Banana_Jack_2Pin | $ | 0.39
L1 | 1 INDUCTOR | Inductor_THT:L_Toroid_Horizontal_D32.5mm_P28.90mm_Bourns_2300 | $ | 2.30
Q1 | 1 Q_NMOS_DGS | Package_TO_SOT_SMD:PQFN_8x8 | $ | 1.82
R1 | 1 150 | Resistor_THT:R_Axial_DIN0309_L9.0mm_D3.2mm_P12.70mm_Horizontal | $ | 0.01
R10 | 1 10K | Resistor_THT:R_Axial_DIN0309_L9.0mm_D3.2mm_P12.70mm_Horizontal | $ | 0.01
R11 | 1 2K | Resistor_THT:R_Axial_DIN0309_L9.0mm_D3.2mm_P12.70mm_Horizontal | $ | 0.01
R12 | 1 4K | Resistor_THT:R_Axial_DIN0309_L9.0mm_D3.2mm_P12.70mm_Horizontal | $ | 0.20
R2 | 1 9.1K | Resistor_THT:R_Axial_DIN0309_L9.0mm_D3.2mm_P12.70mm_Horizontal | $ | 0.15
R3 | 1 8.2K | Resistor_THT:R_Axial_DIN0309_L9.0mm_D3.2mm_P12.70mm_Horizontal | $ | 0.01
R4 | 1 51K | Resistor_THT:R_Axial_DIN0309_L9.0mm_D3.2mm_P12.70mm_Horizontal | $ | 0.01
R5 | 1 510 | Resistor_THT:R_Axial_DIN0309_L9.0mm_D3.2mm_P12.70mm_Horizontal | $ | 0.01
R6 R13 | 2 1K | Resistor_THT:R_Axial_DIN0309_L9.0mm_D3.2mm_P12.70mm_Horizontal | $ | 0.01
R7 R8 | 2 5.1K | Resistor_THT:R_Axial_DIN0309_L9.0mm_D3.2mm_P12.70mm_Horizontal | $ | 0.01
R9 | 1 0.2 | Resistor_THT:R_Axial_DIN0309_L9.0mm_D3.2mm_P12.70mm_Horizontal | $ | 1.49
U1 | 1 TLP250 | Package_DIP:DIP-8_W7.62mm | $ | 0.68
U2 | 1 ATA00B36S-L | Converter_DCDC:Converter_DCDC_Artesyn_ATA_SMD | $ | 16.39
U3 | 1 TL494 | Package_DIP:DIP-16_W7.62mm | $ | 0.19

Total Price :
https://www.pcbway.com/QuickOrderOnline.aspx | PCB Price
Overall
Per Piece
Core Eq | https://www.digikey.com/product-detail/en/tdk-electronics-inc/B66381G0000X172/495-76794-ND/3914869
Around 1 dollars
Cable | AWG #22 - Around 1 dollars

Total Price | Datasheet
$ | 2,000.00 https://www.mag-inc.com/Media/Magnetics/Datasheets/0F43515EC.pdf
$ | 61.00 https://www.digikey.com/product-detail/en/murata-electronics/GRM155R60J225ME15D/490-4519-1-ND/1033278
$ | 9.00 https://www.digikey.com/product-detail/en/murata-electronics/GRM155R71H473KE14D/490-10702-1-ND/5251398
$ | 380.00 https://product.tdk.com/info/en/documents/chara_sheet/C3216JB1E336M160AC.pdf
$ | 720.00 https://www.digikey.com/product-detail/en/vishay-semiconductor-diodes-division/SS5P10-M3-86A/SS5P10-M3-86AGICT-ND/2048223
$ | 1,170.00 https://www.digikey.com/product-detail/en/cinch-connectivity-solutions-johnson/108-0901-001/J150-ND/5928
$ | 2,300.00 https://www.digikey.com/product-detail/en/bourns-inc/2300LL-681-H-RC/2300LL-681-H-RC-ND/725890
$ | 1,820.00 https://www.digikey.com/product-detail/en/on-semiconductor/FDMS86255/FDMS86255TR-ND/4555505
$ | 7.30 https://www.digikey.com/product-detail/en/stackpole-electronics-inc/CF14JT150R/CF14JT150RCT-ND/1830603
$ | 7.30 https://www.digikey.com/product-detail/en/stackpole-electronics-inc/CF14JT10K0/CF14JT10K0CT-ND/1830374
$ | 7.30 https://www.digikey.com/product-detail/en/stackpole-electronics-inc/CF14JT2K00/CF14JT2K00CT-ND/1830357
$ | 200.00 https://www.digikey.com/product-detail/en/vishay-dale/CMF554K0000FEBF/CMF554K0000FEBF-ND/3634189
$ | 150.00 https://www.digikey.com/product-detail/en/yageo/MFP-25BRD52-9K1/9-1KADCT-ND/2059152
$ | 7.30 https://www.digikey.com/product-detail/en/stackpole-electronics-inc/CF14JT8K20/CF14JT8K20CT-ND/1830372
$ | 7.30 https://www.digikey.com/product-detail/en/stackpole-electronics-inc/CF14JT51K0/CF14JT51K0CT-ND/1830392
$ | 7.30 https://www.digikey.com/product-detail/en/stackpole-electronics-inc/CF14JT510R/CF14JT510RCT-ND/1830343
$ | 14.60 https://www.digikey.com/product-detail/en/stackpole-electronics-inc/CF14JT1K00/CF14JT1K00CT-ND/1830350
$ | 14.60 https://www.digikey.com/product-detail/en/stackpole-electronics-inc/CF14JT5K10/CF14JT5K10CT-ND/1830367
$ | 1,490.00 https://www.digikey.com/product-detail/en/ohmite/15FR200E/15FR200E-ND/822920
$ | 680.00 http://toshiba.semicon-storage.com/info/docget.jsp?did=16821&prodName=TLP250
$ | 16,390.00 https://www.artesyn.com/power/assets/ata_series_ds_01apr2015_79c25814fd.pdf
$ | 186.00 http://www.ti.com/lit/ds/symlink/tl494.pdf
$ | 27,629.00
$ | 1,320.00
$ | 28,949.00
$ | 28.95

## References

[1] Transformer Design with Magnetics Ferrite Cores. [Online]. Available: https://www.mag-inc.com/Design/Design-Guides/Transformer-Design-with-Magnetics-Ferrite-Cores.
[2] "AN-776 20 Watt Simple Switcher Forward Converter", 2020. [Online]. Available: https://www.ti.com/lit/an/snva027a/snva027a.pdf?ts=1592752724490
[3] N. Mohan, T. M. Undeland, and W. P. Robbins, Power Electronics: Converters, Applications, and Design. Hoboken, NJ: John Wiley & Sons, 2003.
[4] "Compensator | Design | Procedure | for | Buck | Converter | with | Voltage-Mode | Error-
Amplifier", Infineon.com, 2020. [Online]. Available: | https://www.infineon.com/dgdl/an-
1162.pdf?fileId=5546d462533600a40153559a8e17111a.
[5] Designing Switching Voltage Regulators With the TL494", 2020. [Online]. Available: https://www.ti.com/lit/an/slva001e/slva001e.pdf?ts=1592314978873

51
