buryalcin/EE464_Hardware_POWERLOVERS/EE464_design.xlsx

 |  |  |  |  |  |  |  |  | 0R43515EC
Vin | 48 |  |  |  |  |  |  |  | https://www.mag-inc.com/Media/Magnetics/Datasheets/0R43515EC.pdf
P | 48
f | 25000
 |  |  | Bop | 2500 |  | Cross | 0.327
k | 0.0005 |  | Ac | 0.87 |  | Amper | 1.308
Bmax | 2500 |  | N1 | 22.06896552 | 22
D | 500 |  |  |  |  | Iin | 2 | KabloIn | 1.708999925 | 2 | ALAN1 | 14.388
WaAc | 0.768 |  | N3 | 22.06896552 | 22 | Iout | 3.2 | KabloOut | 2.44648318 | 3 | ALAN2 | 43.164
 |  |  | N2 | 44.13793103 | 44 |  |  |  |  |  | ALAN3 | 14.388
 |  |  |  |  |  | IinAll | 2.235371902 |  |  |  |  | 71.94
 |  |  | AL | 2.667e-06
 |  |  |  |  |  |  |  | Res/m | 52.96
 |  |  | Lmag | 0.00129893365
D1 ideal | 15.65 |  |  |  |  |  |  | F | 9.3 |  | BOY | 9.8
D2 ideal | 31.25 |  |  |  |  |  |  | M | 8 |  | EN | 8
 |  |  | Imag | 0.2353719022
 |  |  |  |  |  |  |  |  |  |  | ALAN | 156.8
 |  |  |  |  |  |  |  | Length | 54.34955291 |  | FF | 0.4588010204
D1 NON | 43.5
D2 NON | 22.05 |  |  |  |  |  |  | R1 | 31.66187554
 |  |  |  |  |  |  |  | R2 | 42.21583406
 |  |  |  |  |  |  |  | R3 | 31.66187554
 | Compansator
 | f_lc | 1110
 | f_esr | 1760000
