buryalcin/EE464_Hardware_POWERLOVERS/Report/Figs/bode_24_ideal.png

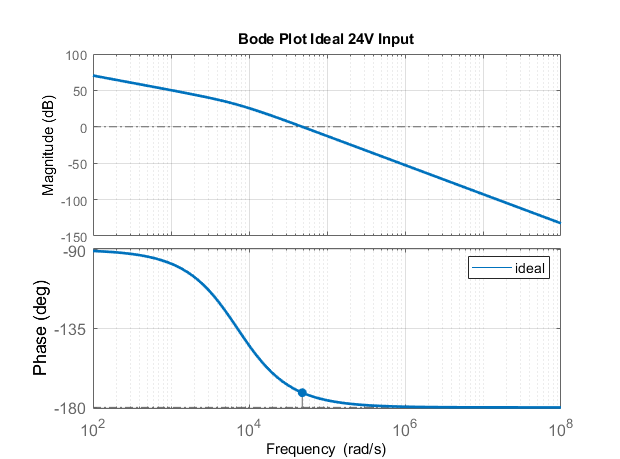
Report/Figs/bode_24_ideal.png
