buryalcin/EE464_Hardware_POWERLOVERS/Report/Figs/bode_24_non.png

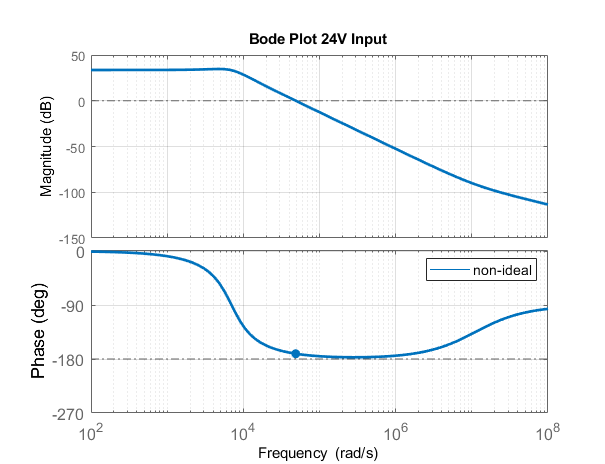
Report/Figs/bode_24_non.png
