buryalcin/EE464_Hardware_POWERLOVERS/Report/Figs/bode_48_ideal.png

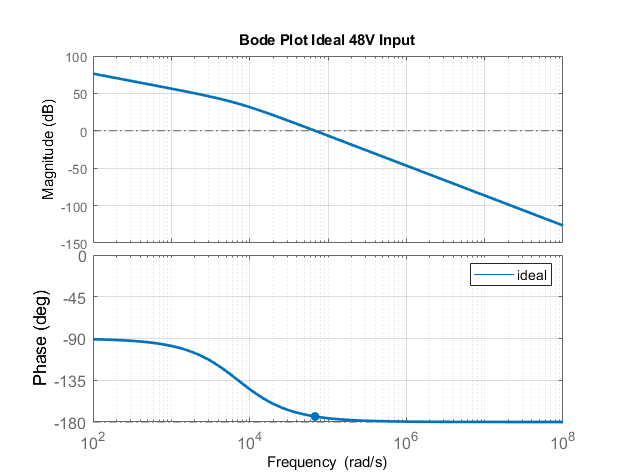
Report/Figs/bode_48_ideal.png
