buryalcin/EE464_Hardware_POWERLOVERS/Report/Figs/bode_worst.png

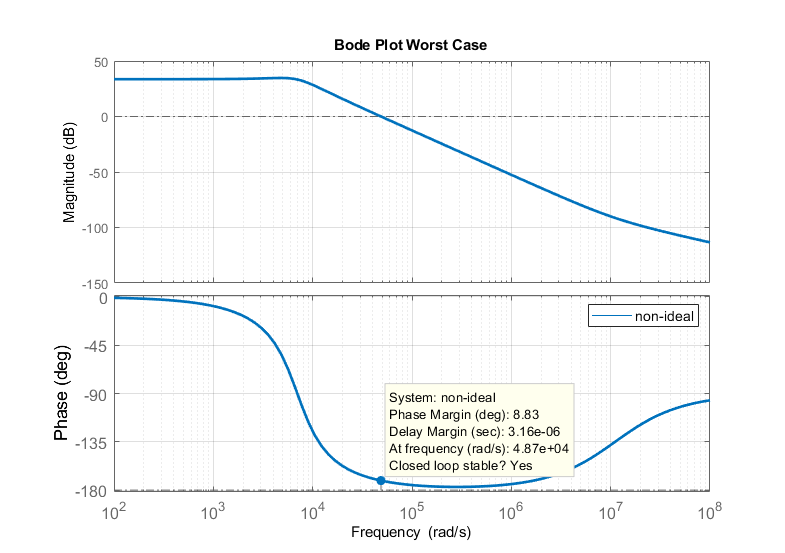
Report/Figs/bode_worst.png
