buryalcin/EE464_Hardware_POWERLOVERS/Report/Figs/inductor_current.png

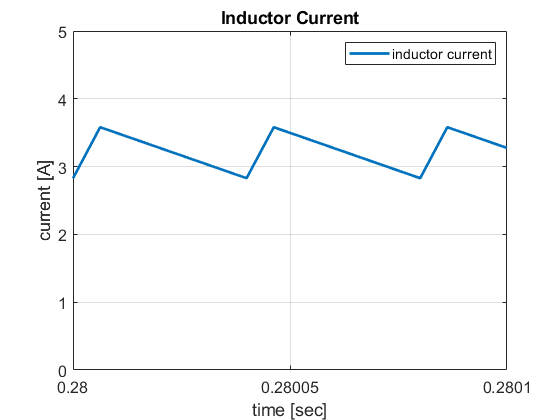
Report/Figs/inductor_current.png
