buryalcin/EE464_Hardware_POWERLOVERS/Report/Figs/input_current.png

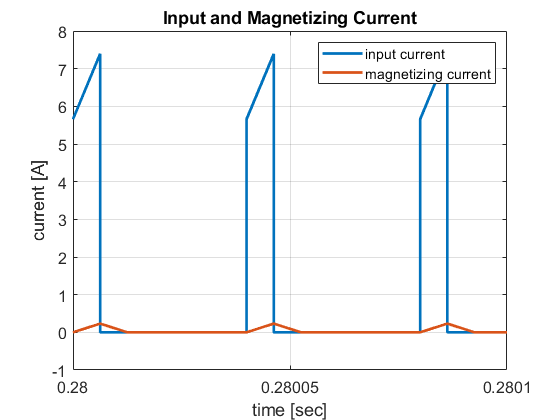
Report/Figs/input_current.png
