buryalcin/EE464_Hardware_POWERLOVERS/Report/Figs/input_current_24.png

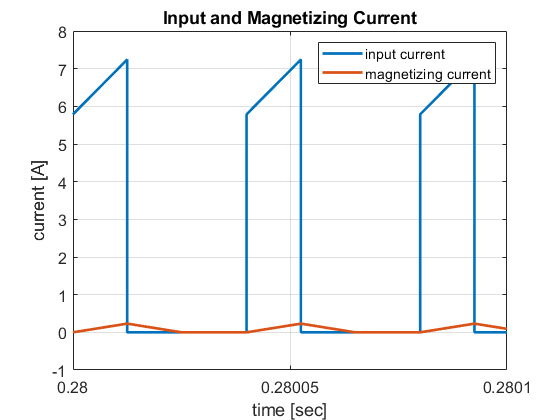
Report/Figs/input_current_24.png
