buryalcin/EE464_Hardware_POWERLOVERS/Report/Figs/input_current_24_com.png

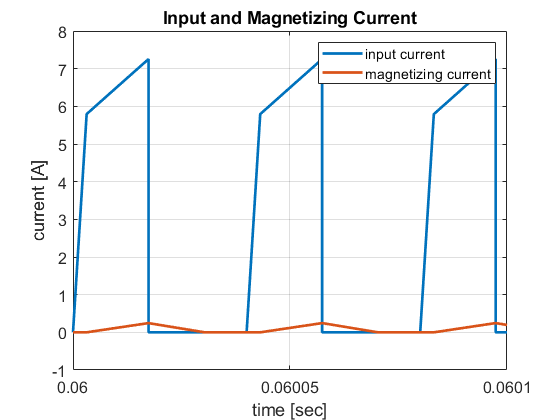
Report/Figs/input_current_24_com.png
