buryalcin/EE464_Hardware_POWERLOVERS/Report/Figs/nosnubber.png

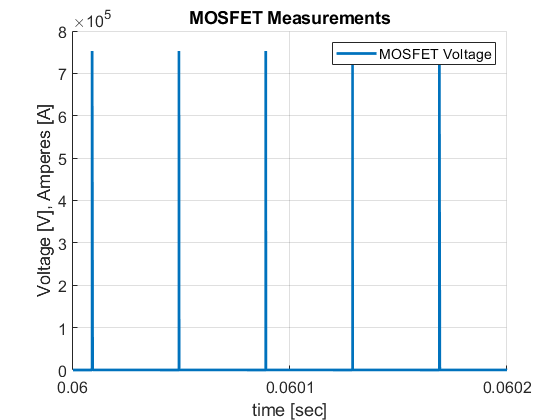
Report/Figs/nosnubber.png
