buryalcin/EE464_Hardware_POWERLOVERS/Report/Figs/output_voltage.png

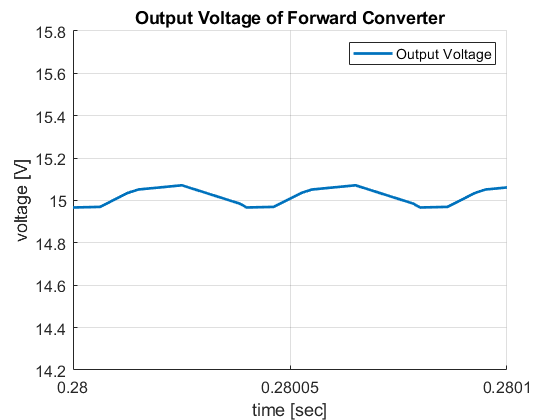
Report/Figs/output_voltage.png
