buryalcin/EE464_Hardware_POWERLOVERS/Report/Figs/output_voltage_com.png

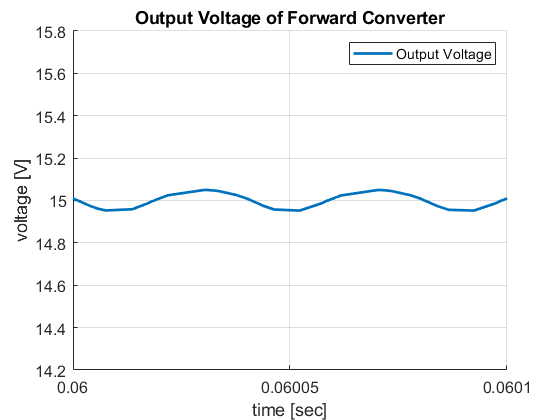
Report/Figs/output_voltage_com.png
