buryalcin/EE464_Hardware_POWERLOVERS/Report/Figs/output_voltage_non48.png

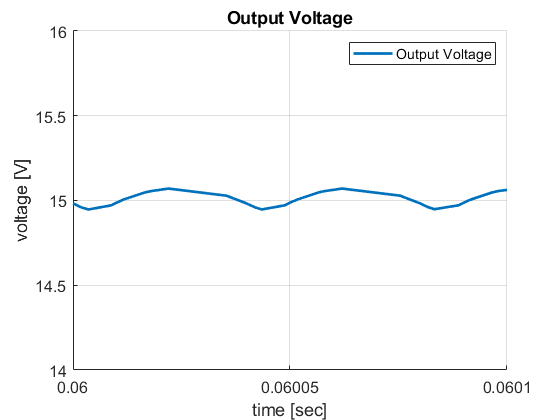
Report/Figs/output_voltage_non48.png
