buryalcin/EE464_Hardware_POWERLOVERS/Report/Figs/output_voltage_non.png

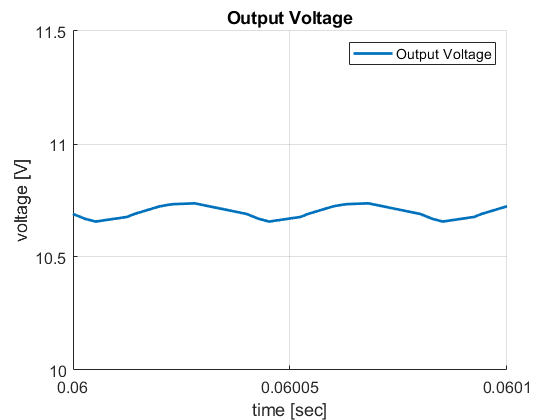
Report/Figs/output_voltage_non.png
