buryalcin/EE464_Hardware_POWERLOVERS/Report/Figs/snubber.png

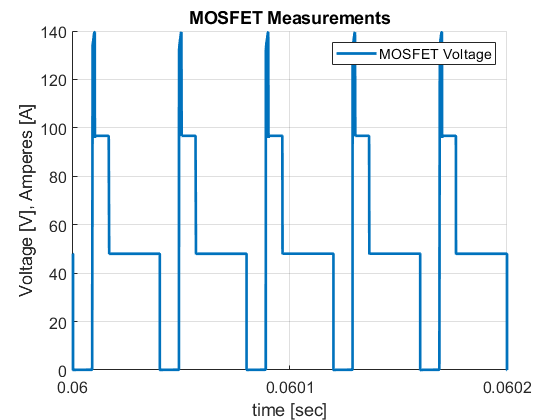
Report/Figs/snubber.png
