buryalcin/EE464_Hardware_POWERLOVERS/Report/Figs/snubberLay.PNG

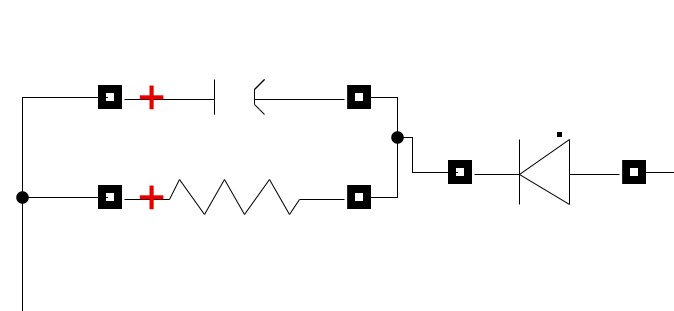
Report/Figs/snubberLay.PNG
