buryalcin/EE464_Hardware_POWERLOVERS/Report/Figs/switchOFF.PNG

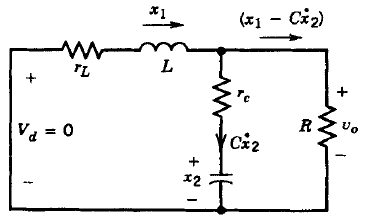
Report/Figs/switchOFF.PNG
