buryalcin/EE464_Hardware_POWERLOVERS/Report/Figs/switchON.PNG

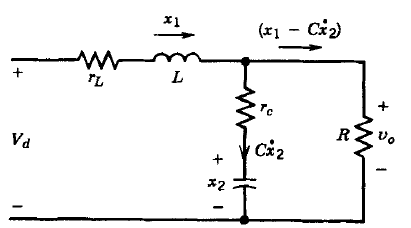
Report/Figs/switchON.PNG
