buryalcin/EE464_Hardware_POWERLOVERS/Report/Figs/snubber_result.png

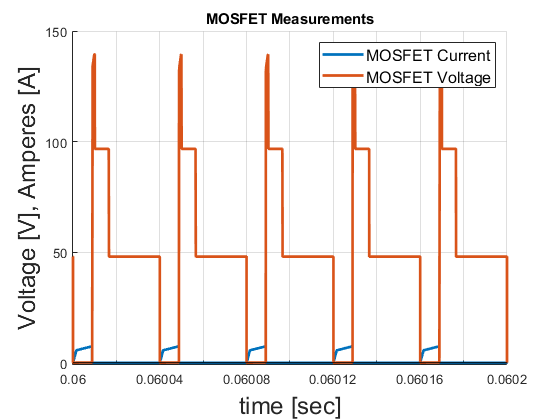
Report/Figs/snubber_result.png
