buryalcin/EE464_Hardware_POWERLOVERS/results/input24.png

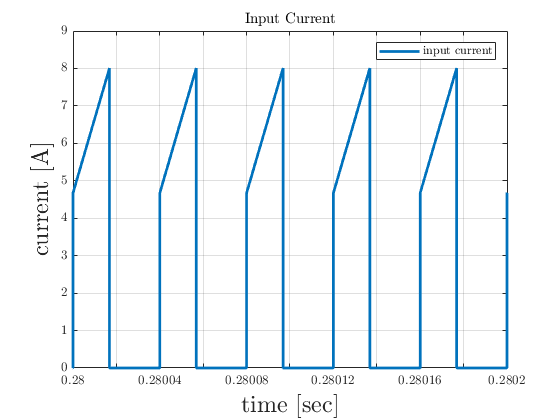
results/input24.png
