buryalcin/EE464_Hardware_POWERLOVERS/results/input48.png

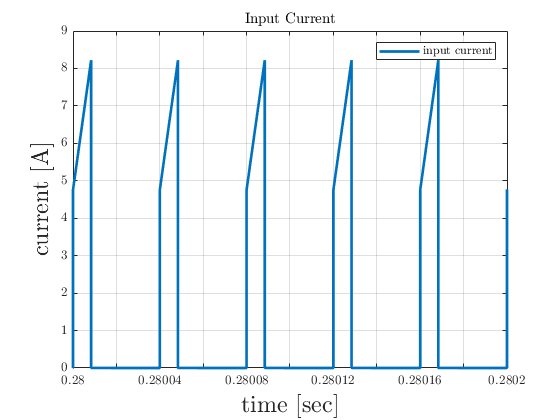
results/input48.png
