buryalcin/EE464_Hardware_POWERLOVERS/results/primarydiode2.png

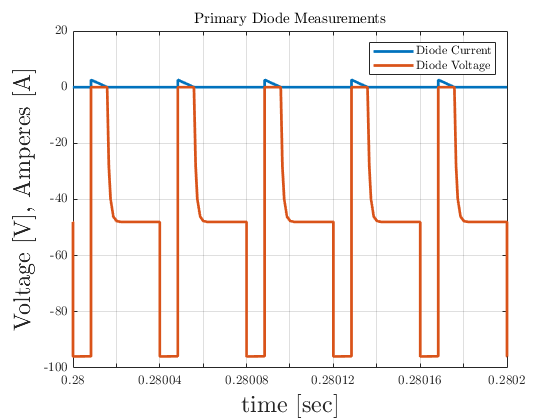
results/primarydiode2.png
