buryalcin/EE464_Hardware_POWERLOVERS/results/secondary2diode.png

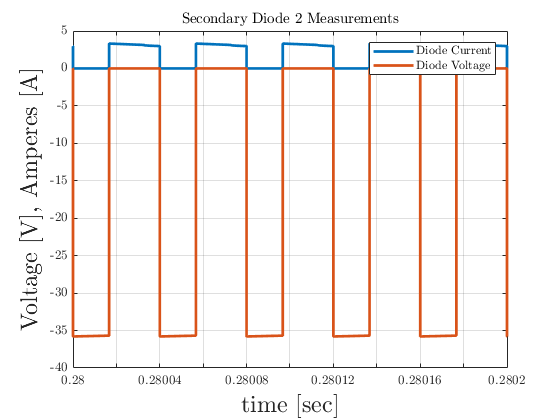
results/secondary2diode.png
