buryalcin/EE464_Hardware_POWERLOVERS/LTspice/compansator_forward_2.asc

C1: cap; 33µ; Rser=3m
C2: cap; 0.5µ
CC1: cap; 139n
CC2: cap; 2.33n
CF3: cap; 2.2n
D1: diode
D2: diode; RFN20T2D
D3: diode
D4: diode
L1: ind2; 1.3m; Rser=1m
L2: ind2; 5.2m; Rser=1m
L3: ind2; 1.3m; Rser=1m
L4: ind; 0.68m; Rser=60m
L5: ind; 10µ
M1: nmos; IPI110N20N3
R1: res; 5.46k
R2: res; 1250
R5: res; 4.69
RF1: res; 170k
RF2: res; 14.8k
RF3: res; 2.55k
U1: UniversalOpamp2
U2: UniversalOpamp2
V1: voltage; 48
V2: voltage; PULSE(0 1.8 0 39.9u 0 0 40u)
V3: voltage; 10
V4: voltage; 1.2
Named nets: 0, Voutput, V_in
.tran 0 10ms 7ms 0.01ms
K L1 L2 L3 1
K L1 L2 L3 1
