buryalcin/EE464_Hardware_POWERLOVERS/LTspice/compansator_forward_4.asc

C1: cap; 33µ; Rser=3m
CC1: cap; 416n
CC2: cap; 2.91n
CF3: cap; 2.2n
D1: diode
D3: diode
L1: ind2; 1.3m; Rser=0
L2: ind2; 5.2m; Rser=0
L4: ind; 0.68m; Rser=60m
M1: nmos; IPP147N12N3
M2: nmos; IPP147N12N3
R1: res; 4.37k
R2: res; 9.2
R5: res; 9.2
RF1: res; 410k
RF2: res; 35.6k
RF3: res; 3.16k
U1: UniversalOpamp2
U2: UniversalOpamp2
V1: voltage; 48; Rser=0
V2: voltage; PULSE(0 1.8 0 39.9u 0 0 40u)
V3: voltage; 5
V4: voltage; 1.2
V5: voltage; PULSE(0 5 0 1u 0 15m)
Named nets: 0, Voutput, V_in
.tran 0 20ms 0 0.01ms
K L1 L2 1
K L1 L2 1
