buryalcin/EE464_Hardware_POWERLOVERS/LTspice/compansator_plotlari_al.asc

C1: cap; 33µ; Rser=3m
CC1: cap; 139.1n
CC2: cap; 2.33n
CF3: cap; 2.2n
D1: diode
D2: diode; RF1501TF3S
D3: diode
L1: ind2; 1.3m; Rser=30m
L2: ind2; 5.2m; Rser=40m
L3: ind2; 1.3m
L4: ind; 0.68m; Rser=60m
M1: nmos; IPP200N25N3
M2: nmos; IPP147N12N3
R1: res; 5.46k
R2: res; 4.87
R5: res; 46.87
RF1: res; 170k
RF2: res; 10.865k
RF3: res; 2.55k
U1: UniversalOpamp2
U2: UniversalOpamp2
V1: voltage; 48; Rser=0
V2: voltage; PULSE(0 1.8 0 20u 19.9u 0 40u)
V3: voltage; 5
V4: voltage; 0.9
V5: voltage; PULSE(0 5 0 1u 0 15m)
Named nets: 0, Voutput, V_in
.tran 0 20ms 0ms 0.01ms
K L1 L2 1
K L1 L2 L3 1
