buryalcin/EE464_Hardware_POWERLOVERS/LTspice/compansator_forward.asc

C1: cap; 33µ; Rser=5m
CC1: cap; 186n
CC2: cap; 2.93n
CF3: cap; 2.2n
D1: diode
D2: diode
D3: diode
L1: ind2; 1.3m; Rser=1m
L2: ind2; 2.925m; Rser=1m
L3: ind2; 1.3m; Rser=1m
L4: ind; 0.675m; Rser=60m
L5: ind; 10µ
M1: nmos; BSZ900N20NS3
R1: res; 8568
R5: res; 4.69
RF1: res; 273.5K
RF2: res; 23.8K
RF3: res; 2.1k
U1: UniversalOpamp2
U2: UniversalOpamp2
V1: voltage; 48
V2: voltage; PULSE(0 1.8 0 39.9u 0 0 40u)
V3: voltage; 10
V4: voltage; 1.2
Named nets: 0, Voutput, V_in
.tran 0 10ms 0.01ms 0.01ms
K L1 L2 L3 1
K L1 L2 L3 1
