buryalcin/EE464_Hardware_POWERLOVERS/PCB_Design/PCB_Design.kicad_pcb

## KiCad design PCB_Design/PCB_Design.kicad_pcb (2020-06-23)

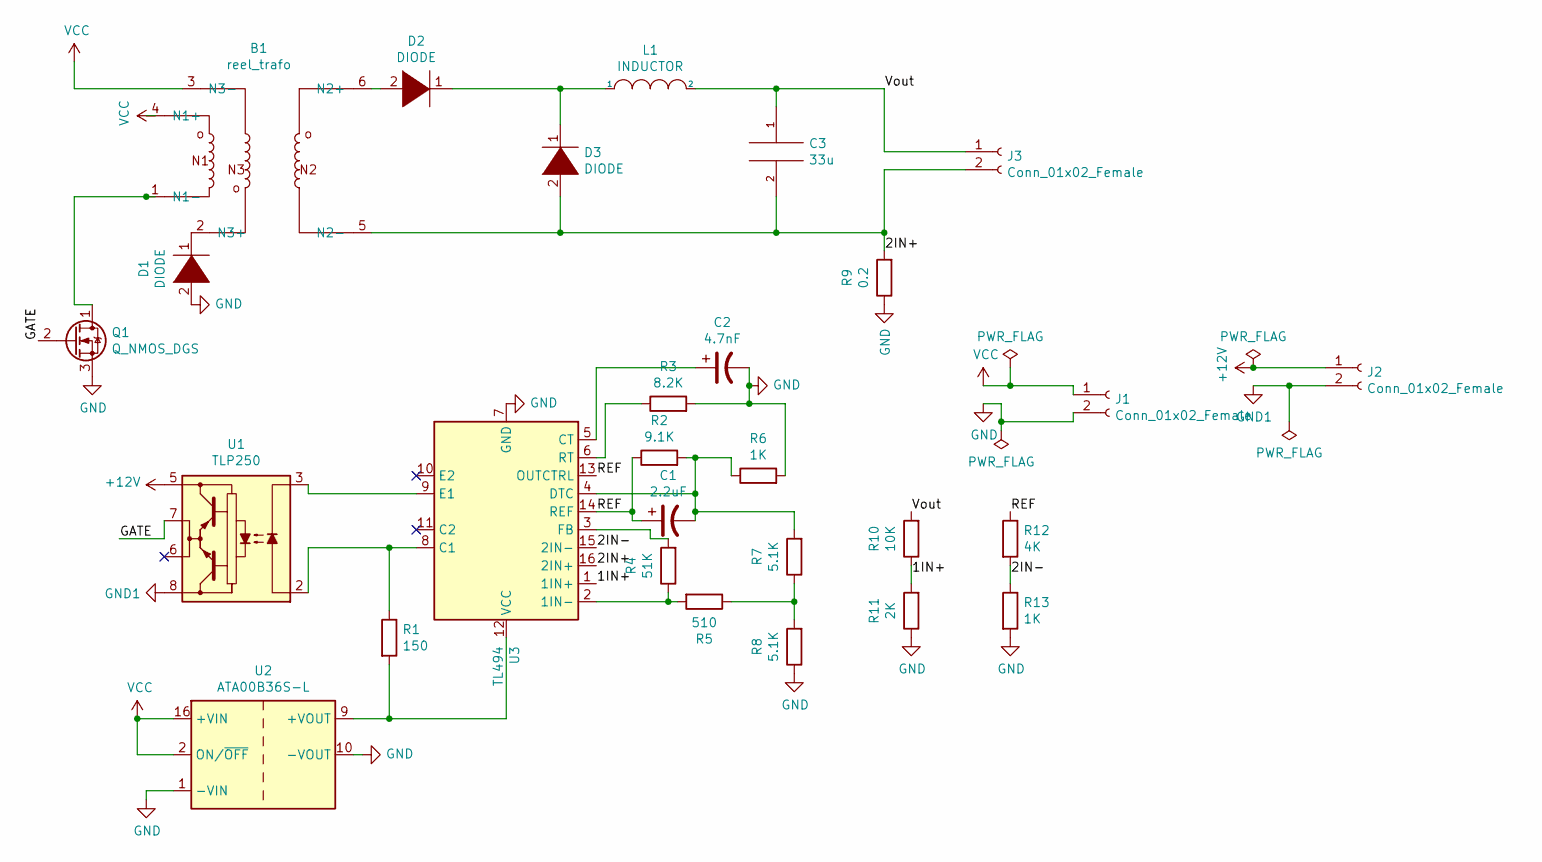
[picture p78: schematic PCB_Design.sch]

Parts:
B1: reel_trafo; trafo
C1: 2.2uF; C_1206_3216Metric_Pad1.42x1.75mm_HandSolder
C2: 4.7nF; C_1206_3216Metric_Pad1.42x1.75mm_HandSolder
C3: 33u; C_1206_3216Metric_Pad1.42x1.75mm_HandSolder
D1, D2, D3: DIODE; TO-277A
J1, J2, J3: Conn_01x02_Female; Banana_Jack_2Pin
L1: INDUCTOR; L_Toroid_Horizontal_D32.5mm_P28.90mm_Bourns_2300
Q1: Q_NMOS_DGS; PQFN_8x8
R1: 150; R_Axial_DIN0309_L9.0mm_D3.2mm_P12.70mm_Horizontal
R2: 9.1K; R_Axial_DIN0309_L9.0mm_D3.2mm_P12.70mm_Horizontal
R3: 8.2K; R_Axial_DIN0309_L9.0mm_D3.2mm_P12.70mm_Horizontal
R4: 51K; R_Axial_DIN0309_L9.0mm_D3.2mm_P12.70mm_Horizontal
R5: 510; R_Axial_DIN0309_L9.0mm_D3.2mm_P12.70mm_Horizontal
R6, R13: 1K; R_Axial_DIN0309_L9.0mm_D3.2mm_P12.70mm_Horizontal
R7, R8: 5.1K; R_Axial_DIN0309_L9.0mm_D3.2mm_P12.70mm_Horizontal
R9: 0.2; R_Axial_DIN0309_L9.0mm_D3.2mm_P12.70mm_Horizontal
R10: 10K; R_Axial_DIN0309_L9.0mm_D3.2mm_P12.70mm_Horizontal
R11: 2K; R_Axial_DIN0309_L9.0mm_D3.2mm_P12.70mm_Horizontal
R12: 4K; R_Axial_DIN0309_L9.0mm_D3.2mm_P12.70mm_Horizontal
U1: TLP250; DIP-8_W7.62mm
U2: ATA00B36S-L; Converter_DCDC_Artesyn_ATA_SMD
U3: TL494; DIP-16_W7.62mm

Connections:
+12V: J2.1, U1.5 (VEE)
/1IN+: R10.1, R11.2, U3.1 (1IN+)
/2IN+: B1.5 (N2-), C3.2, D3.2 (K), J3.2, R9.2, U3.16 (2IN+)
/2IN-: R12.2, R13.1, U3.15 (2IN-)
/GATE: Q1.2 (G), U1.7 (VO)
/REF: C1.1, R2.1, R12.1, U3.13 (OUTCTRL), U3.14 (REF)
/Vout: C3.1, J3.1, L1.2, R10.2
GND: C2.2, D1.2 (K), J1.2, Q1.3 (S), R3.2, R6.2, R8.1, R9.1, R11.1, R13.2, U2.1 (-VIN), U2.10 (-VOUT), U3.7 (GND)
GND1: J2.2, U1.8 (VCC)
unnamed: B1.1 (N1-), Q1.1 (D)
unnamed: B1.2 (N3+), D1.1 (A)
unnamed: B1.6 (N2+), D2.2 (K)
unnamed: C1.2, R2.2, R6.1, R7.2, U3.4 (DTC)
unnamed: C2.1, U3.5 (CT)
unnamed: D2.1 (A), D3.1 (A), L1.1
unnamed: R1.1, U1.2 (A), U3.8 (C1)
unnamed: R1.2, U2.9 (+VOUT), U3.12 (VCC)
unnamed: R3.1, U3.6 (RT)
unnamed: R4.1, R5.2, U3.2 (1IN-)
unnamed: R4.2, U3.3 (FB)
unnamed: R5.1, R7.1, R8.2
unnamed: U1.3 (C), U3.9 (E1)
VCC: B1.3 (N3-), B1.4 (N1+), J1.1, U2.2 (ON/~OFF), U2.16 (+VIN)

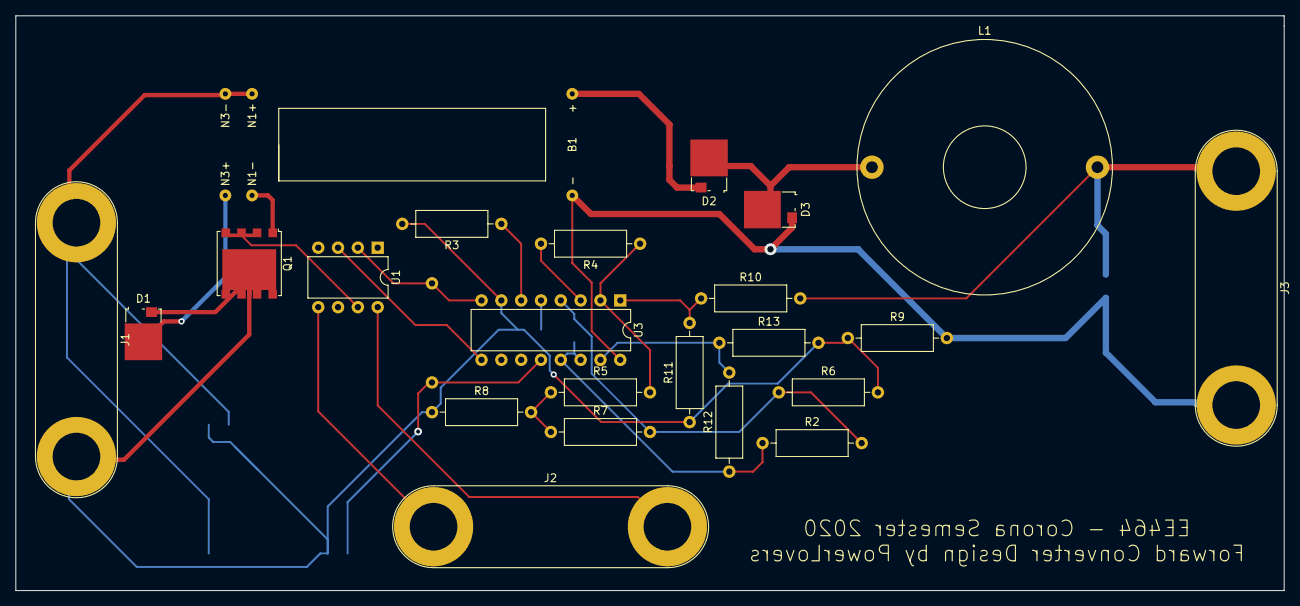
[picture p79: board PCB_Design.kicad_pcb from above]

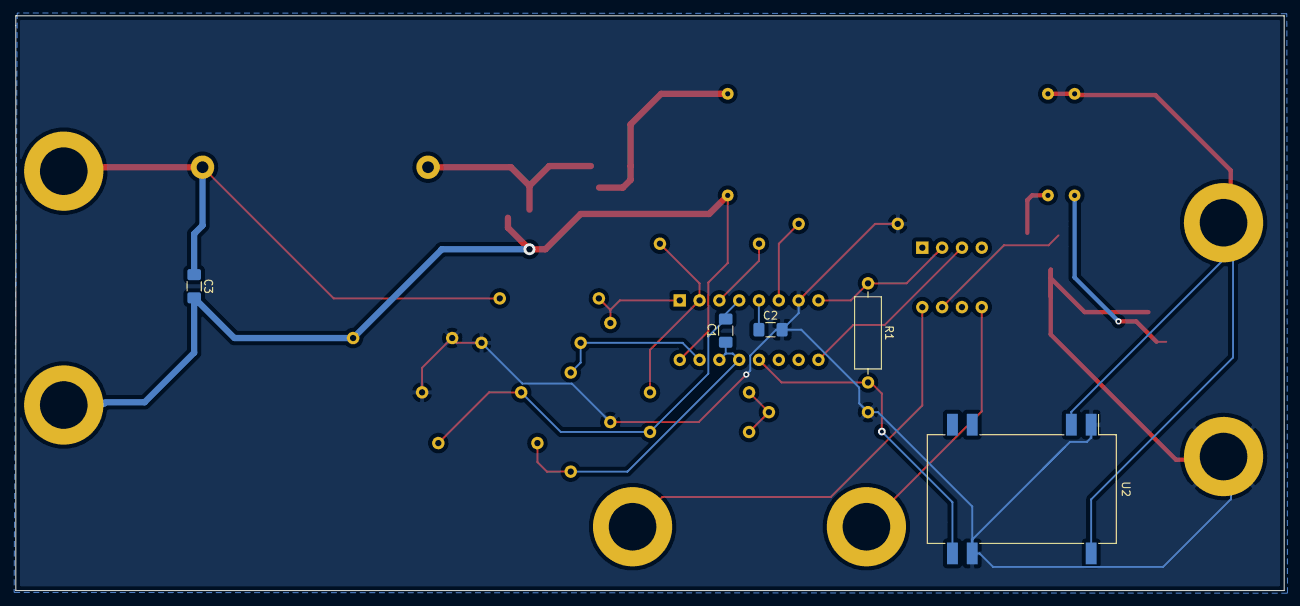
[picture p80: board PCB_Design.kicad_pcb from below]

Board: 2 copper layers, 162.6 x 73.7 mm, 28 parts (5 on the bottom side), 23 nets.
