buryalcin/EE464_Hardware_POWERLOVERS/(commit log)

2020-06-15 Transformator and inductor calculations have been done again with commercial products. We recently worked on the available products, cores, cables etc. However, due to pandemic, now in the software v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
    [EE464_design.xlsx]
2020-06-15 pcb design schematic part is near completion
    [PCB_Design.kicad_pcb, PCB_Design.sch]
2020-06-16 schematic and footprint assoc are done
    [PCB_Design.sch]
2020-06-17 started layout
    [PCB_Design.kicad_pcb, PCB_Design.sch]
2020-06-19 started pcb design, looking good for a newbie
    [PCB_Design.kicad_pcb, PCB_Design.sch]
2020-06-19 pcb design completed
    [PCB_Design.kicad_pcb, PCB_Design.sch]
2020-06-23 design completed. gerber files and bom are added
    [BOM.xlsx, PCB_Design.kicad_pcb, PCB_Design.sch]
2020-06-24 The report is finished. All calculations are in the excel file and matlab files. We added bom pdf and other pdfs as well. Project is finished!
    [EE464_design.xlsx]
